lhhvvp/norma-core-dev/software/station/clients/station-viewer/README.md

# Station Viewer

Web interface for NormaCore.Dev station - physical operations platform.

## Features

- Real-time robot state visualization
- ST3215 servo bus monitoring and calibration
- USB video frame viewing
- System info monitoring
- Timeline-based history navigation
- 3D robot visualization (URDF support)

## Development

```bash
# Install dependencies
yarn install

# Start development server
yarn dev

# Build for production
yarn build

# Type checking
yarn type-check

# Lint
yarn lint
```

## Tech Stack

- React 19
- TypeScript
- Vite
- TailwindCSS
- Three.js
- Protocol Buffers

## License

MIT
