lhhvvp/norma-core-dev/docs/superpowers/plans/2026-04-10-simulation-integration-mvp1.md

# NormaCore Simulation Integration — MVP-1 Implementation Plan

> **For agentic workers:** REQUIRED: Use `superpowers:subagent-driven-development` (if subagents available) or `superpowers:executing-plans` to implement this plan. Steps use checkbox (`- [ ]`) syntax for tracking.

**Goal:** Implement the MVP-1 scope of the v2 simulation integration design so that `station -c station-sim.yaml` boots Station with a MuJoCo-backed simulated ElRobot follower, web UI shows the robot responding to joint commands, the gripper mimic works through MJCF `<equality>` constraints, and shadow mode (real + sim coexistence) is configurable but not required.
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
