lhhvvp/norma-core-dev/hardware/elrobot/simulation/mujoco/elrobot_follower/elrobot_follower.png

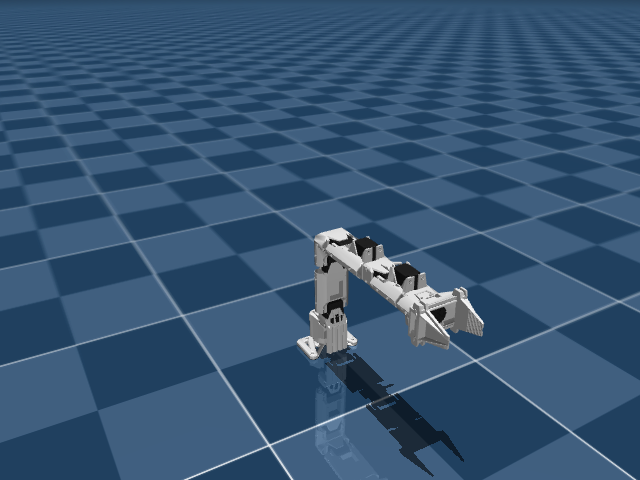
hardware/elrobot/simulation/mujoco/elrobot_follower/elrobot_follower.png
