lhhvvp/norma-core-dev/hardware/elrobot/print/basic/elrobot_full_basic.3mf

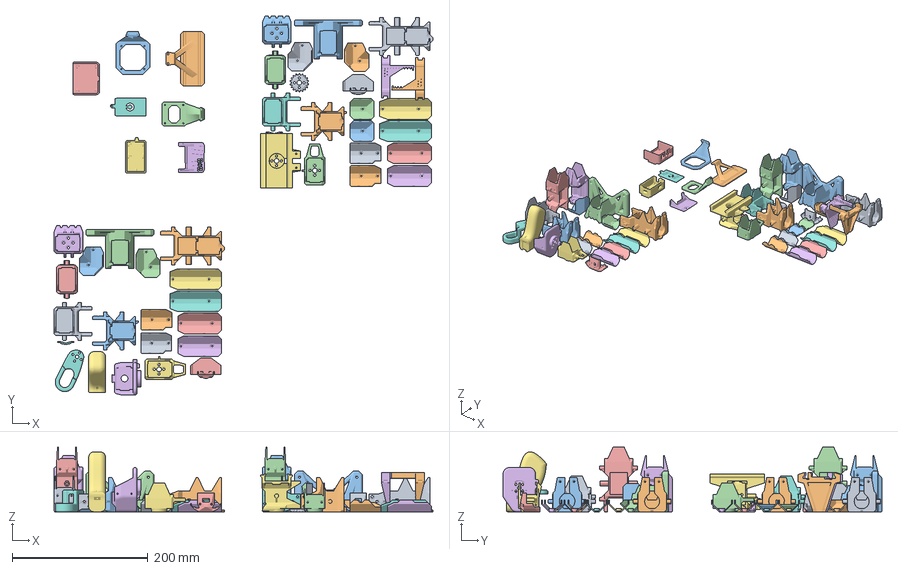
[picture p4: CAD file, 2026-04-08]
hardware/elrobot/print/basic/elrobot_full_basic.3mf
557.0 x 557.5 x 95.0 mm
Base Shield.stl x 2
CameraMount_regular.stl
CameraMount_square_34mm.stl
CameraMount_square_27mm.stl
ws_enclosure_case.stl
ws_enclosure_lid.stl
ss_enclosure_case.stl
ss_enclosure_lid.stl
Gripper Gear.stl
Gripper Jaw.stl x 2
Joint 1.stl x 2
Joint 5.stl x 2
Wiring_bracket.stl x 2
Gripper Base.stl
Joint 3.stl x 2
Joint 4.stl x 2
Joint 6.stl x 2
Base.stl x 2
Joint_02.stl x 2
Wrist_Roll_SO101.stl
Handle_SO101.stl
Trigger_SO101.stl
Joint 3 Shield Drive Side.stl x 2
Joint 3 Shield Camera Side.stl x 2
Gripper Base Shield.stl x 2
Joint 2 Shield.stl x 4
Joint 4 Shield.stl x 4
Joint 6 Shield.stl x 4
