lhhvvp/norma-core-dev/hardware/elrobot/print/ams/elrobot_leader_ams.3mf

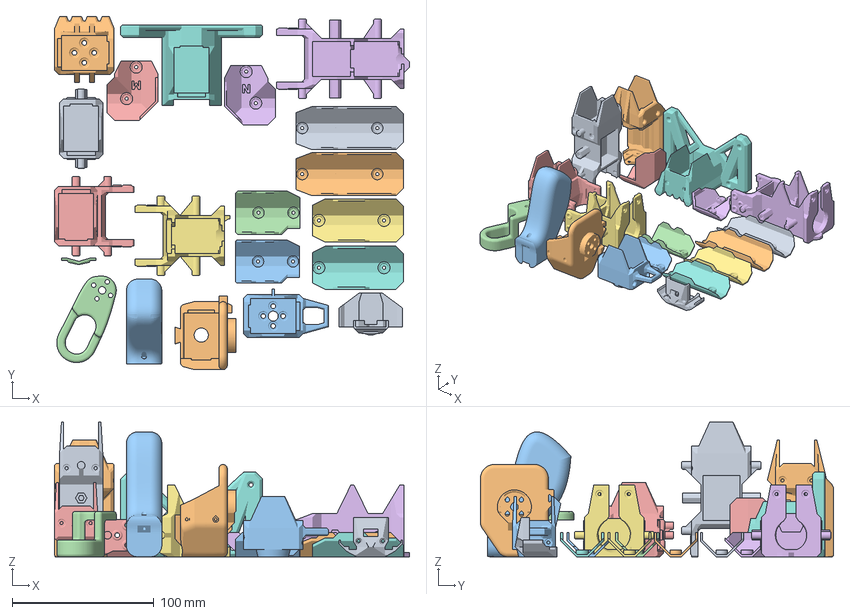
[picture p6: CAD file, 2026-04-08]
hardware/elrobot/print/ams/elrobot_leader_ams.3mf
250.5 x 249.2 x 95.0 mm
Base Shield.stl
Joint 1.stl
Joint 5.stl
Wiring_bracket.stl
Joint 3.stl
Joint 4.stl
Joint 6.stl
Base.stl
Joint_02.stl
Wrist_Roll_SO101.stl
Handle_SO101.stl
Trigger_SO101.stl
Joint 3 Shield Drive Side.stl
Joint 3 Shield Camera Side.stl
Joint 2 Shield.stl x 2
Joint 4 Shield.stl x 2
Joint 6 Shield.stl x 2
