lhhvvp/norma-core-dev/hardware/elrobot/simulation/mujoco/elrobot_follower/assets/Joint_01_1.stl

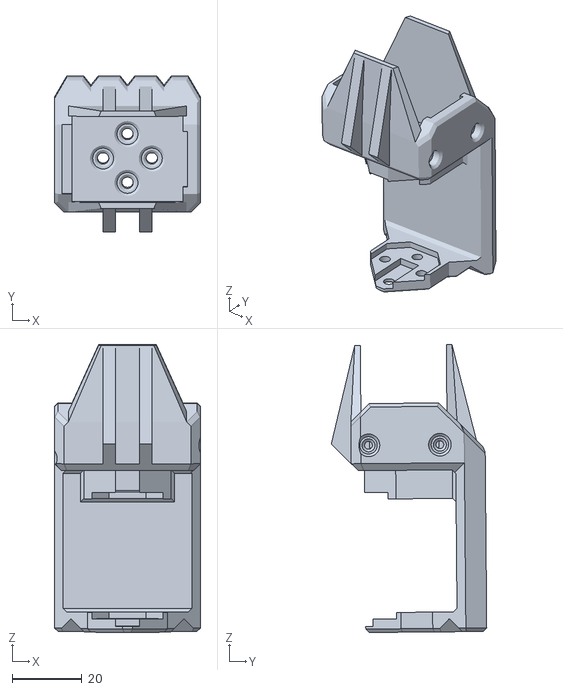
[picture p7: CAD file, 2026-03-16]
hardware/elrobot/simulation/mujoco/elrobot_follower/assets/Joint_01_1.stl
42.0 x 44.7 x 82.7
