lhhvvp/norma-core-dev/hardware/elrobot/STEP/elrobot_common_parts/Joint 6.stp

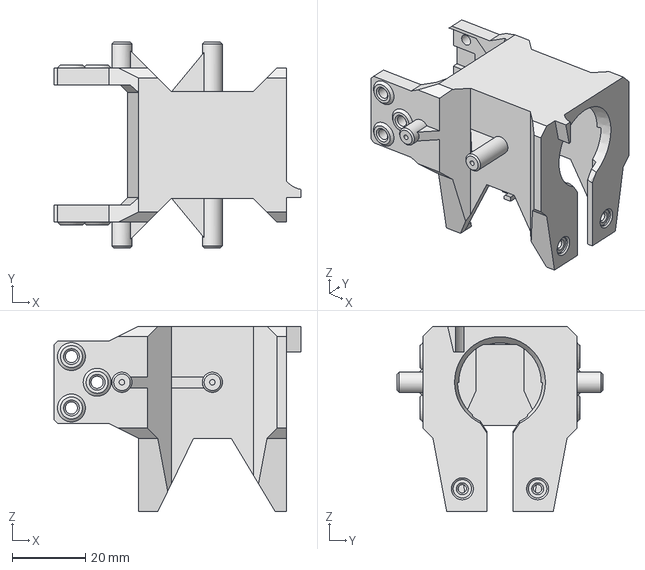
[picture p8: CAD file, 2026-04-03]
hardware/elrobot/STEP/elrobot_common_parts/Joint 6.stp
67.2 x 56.0 x 50.5 mm
