lhhvvp/norma-core-dev/hardware/elrobot/STEP/elrobot_follower_parts/individual/Gripper_Base_Shield.stp

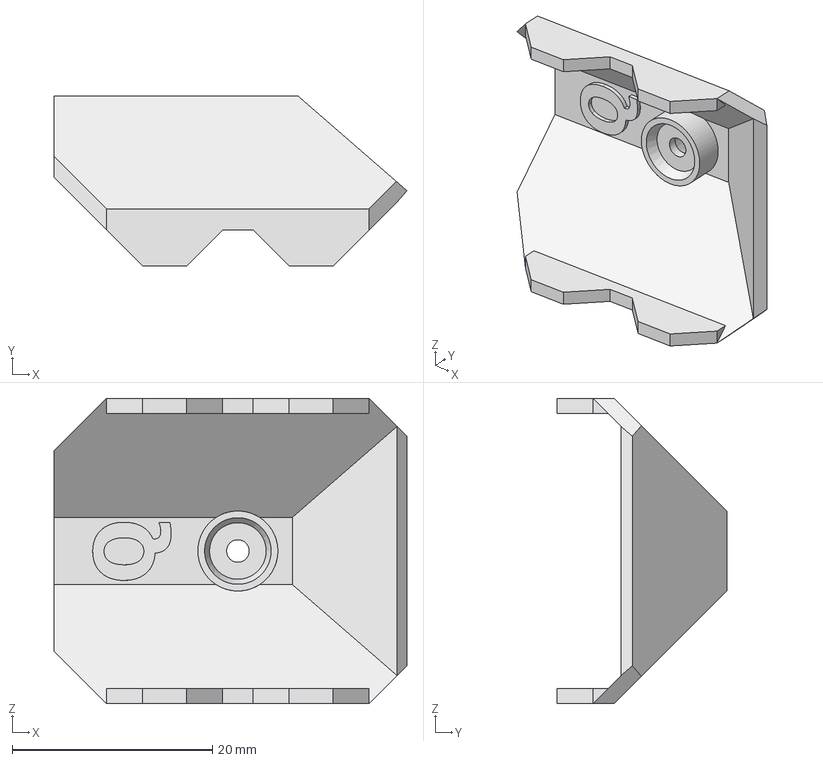
[picture p9: CAD file, 2026-04-08]
hardware/elrobot/STEP/elrobot_follower_parts/individual/Gripper_Base_Shield.stp
35.3 x 17.0 x 30.5 mm
