lhhvvp/norma-core-dev/hardware/pgripper/STEP/Gripper.stp

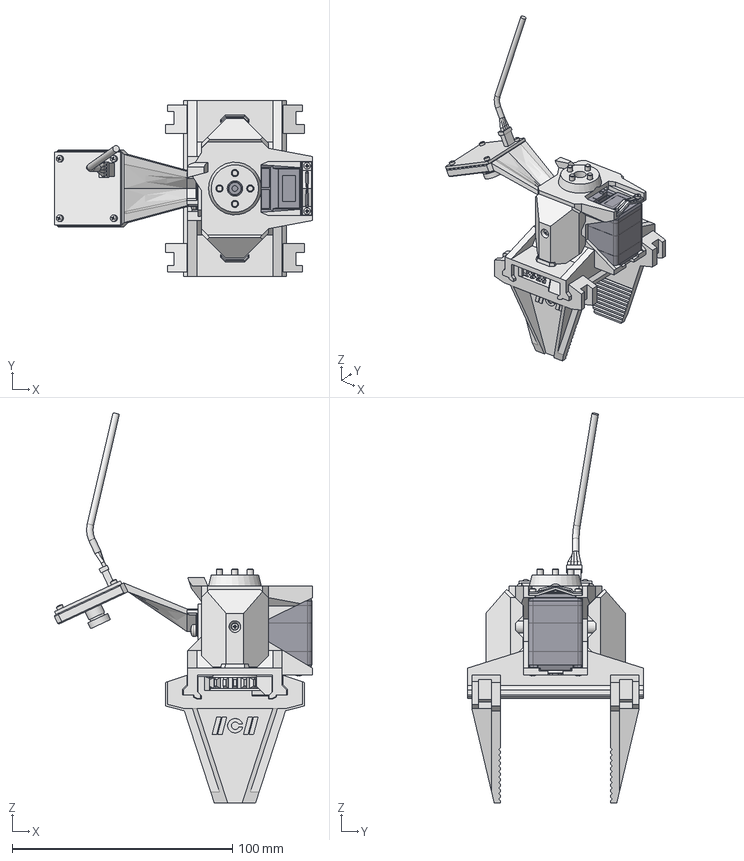
[picture p10: CAD file, 2026-04-08]
hardware/pgripper/STEP/Gripper.stp
117.2 x 80.0 x 177.0 mm
Gripper_Base
Gripper Gear
Gripper_Jaw x 2
Gripper_Base_Shield x 2
CameraMount_square32mm
Wiring_bracket
UVC_Camera
Idler Horn
CRFHTSTATI ANSI B18.6.4 - 1-42 x 3/16 Steel Grade 2 Plain x 10
DIN EN ISO 7045 - M3 x 6 - H Steel 4.6 Plain x 11
Servo ST3215_1
Servo Horn
