lhhvvp/norma-core-dev/hardware/pgripper/STL/print/gripper_34mm_camera_mount.stl

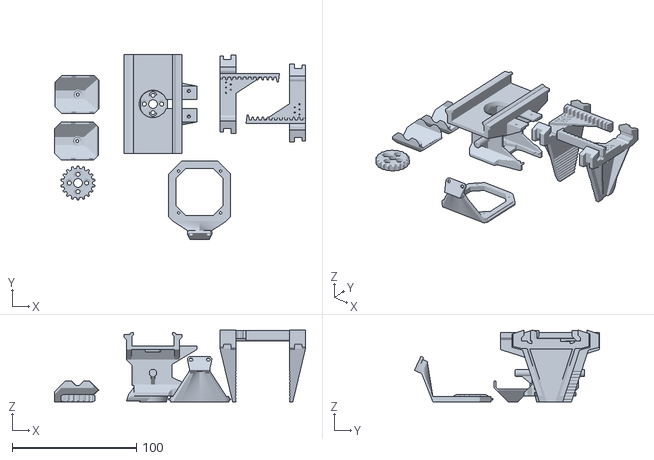
[picture p11: CAD file, 2026-04-08]
hardware/pgripper/STL/print/gripper_34mm_camera_mount.stl
202.2 x 149.2 x 58.0
