lhhvvp/norma-core-dev/software/station/clients/station-viewer/public/so101/assets/leader_wrist_roll_so101_scale_1_1000.stl

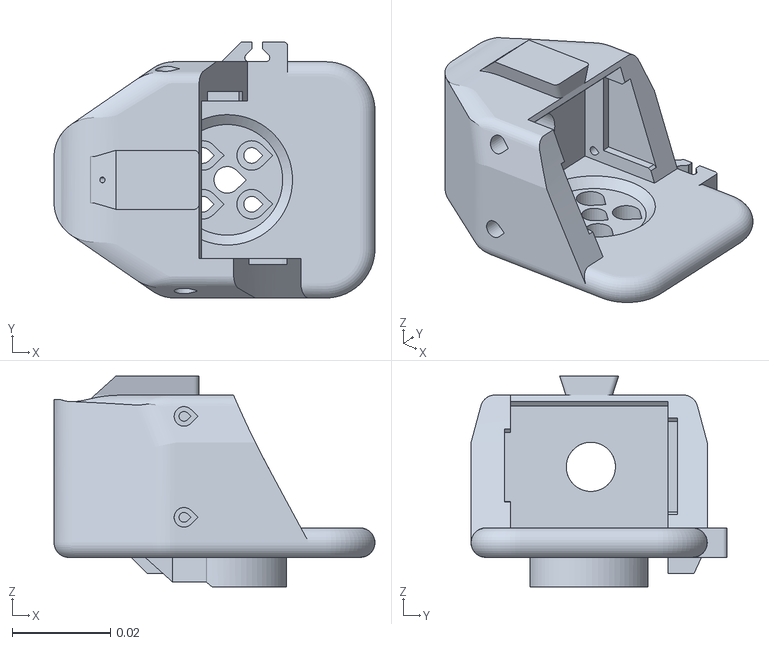
[picture p12: CAD file, 2026-03-16]
software/station/clients/station-viewer/public/so101/assets/leader_wrist_roll_so101_scale_1_1000.stl
0.0652 x 0.052 x 0.0429
