lhhvvp/norma-core-dev/hardware/elrobot/simulation/mujoco/elrobot_follower/assets/Joint_04_v1_1.stl

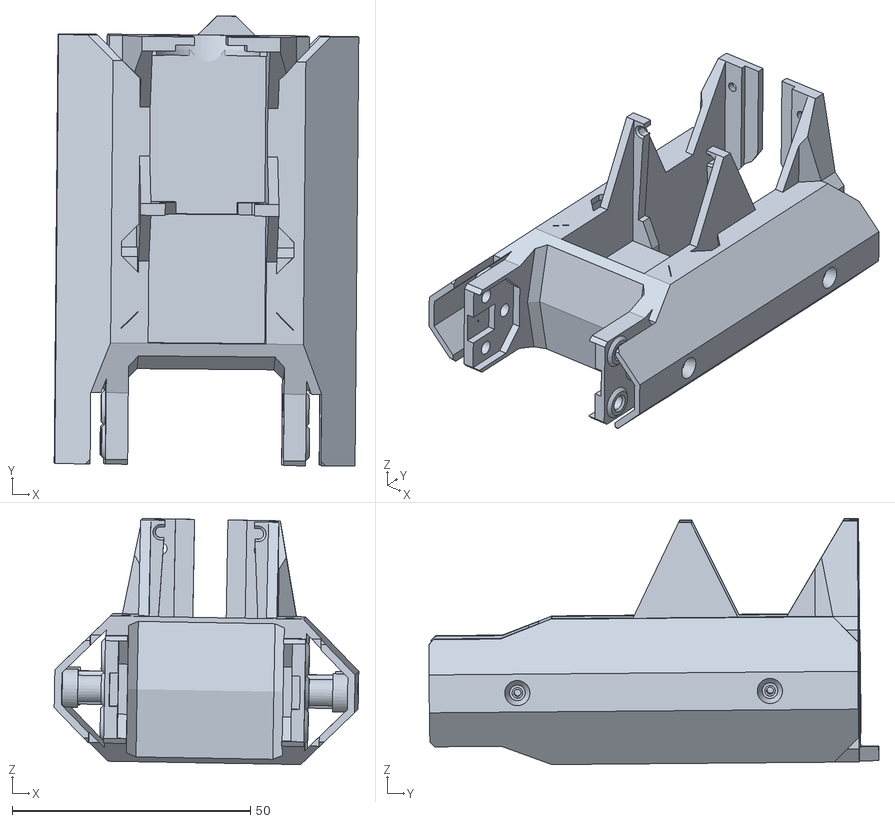
[picture p14: CAD file, 2026-03-16]
hardware/elrobot/simulation/mujoco/elrobot_follower/assets/Joint_04_v1_1.stl
63.9 x 94.4 x 51.7
