lhhvvp/norma-core-dev/hardware/elrobot/STEP/elrobot_follower_parts/individual/Gripper_Base.stp

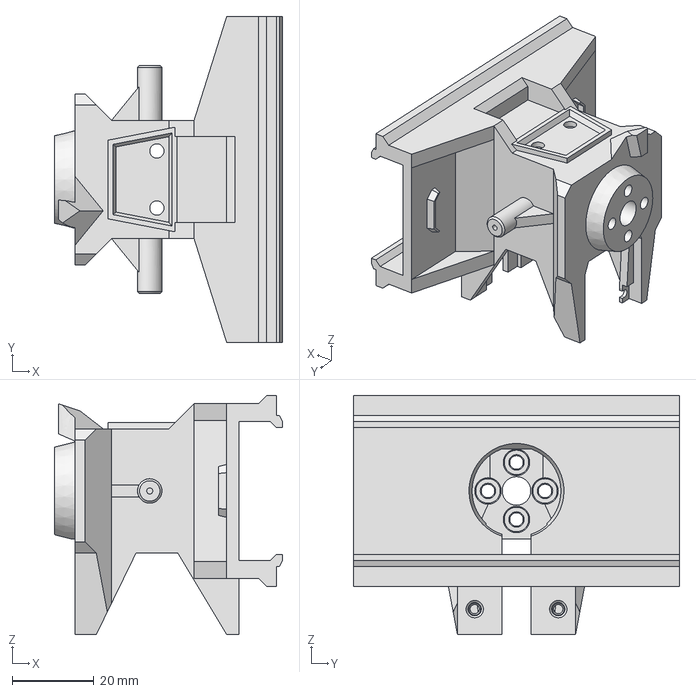
[picture p15: CAD file, 2026-04-03]
hardware/elrobot/STEP/elrobot_follower_parts/individual/Gripper_Base.stp
56.0 x 80.0 x 58.7 mm
