lhhvvp/norma-core-dev/hardware/pgripper/STL/print/basic.3mf

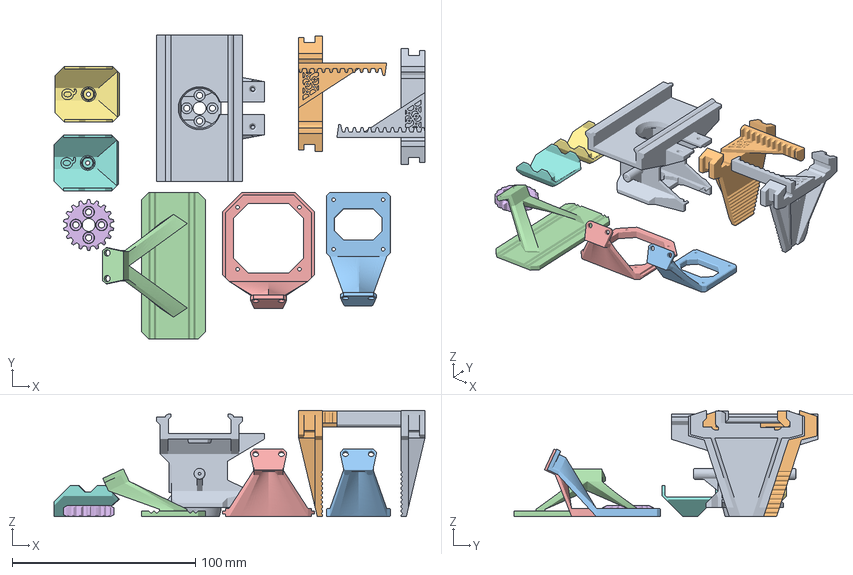
[picture p16: CAD file, 2026-04-08]
hardware/pgripper/STL/print/basic.3mf
202.2 x 165.9 x 58.0 mm
Gripper_Jaw_v04.stl x 2
CameraMount_square32mm_v03.stl
CameraMount_v02.stl
CameraMount_square33,75mm_v01.stl
Gripper_Gear_v01.stl
Gripper_Base_Shield.stl x 2
Gripper_Base.stl
