lhhvvp/norma-core-dev/software/station/clients/station-viewer/public/so101/assets/leader_trigger_so101_scale_1_1000.stl

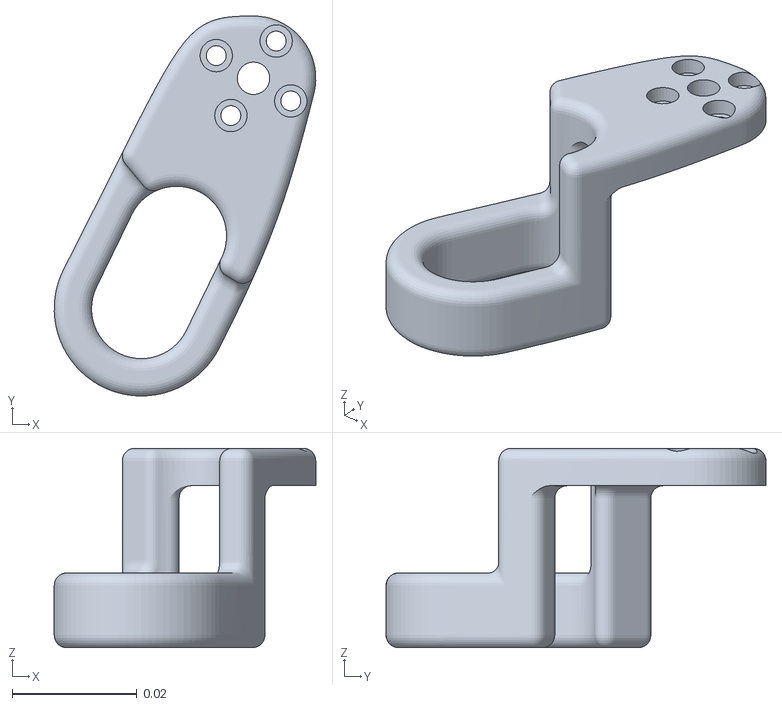
[picture p17: CAD file, 2026-03-16]
software/station/clients/station-viewer/public/so101/assets/leader_trigger_so101_scale_1_1000.stl
0.042 x 0.061 x 0.032
