lhhvvp/norma-core-dev/hardware/elrobot/simulation/mujoco/elrobot_follower/assets/Gripper_Gear_v1_1.stl

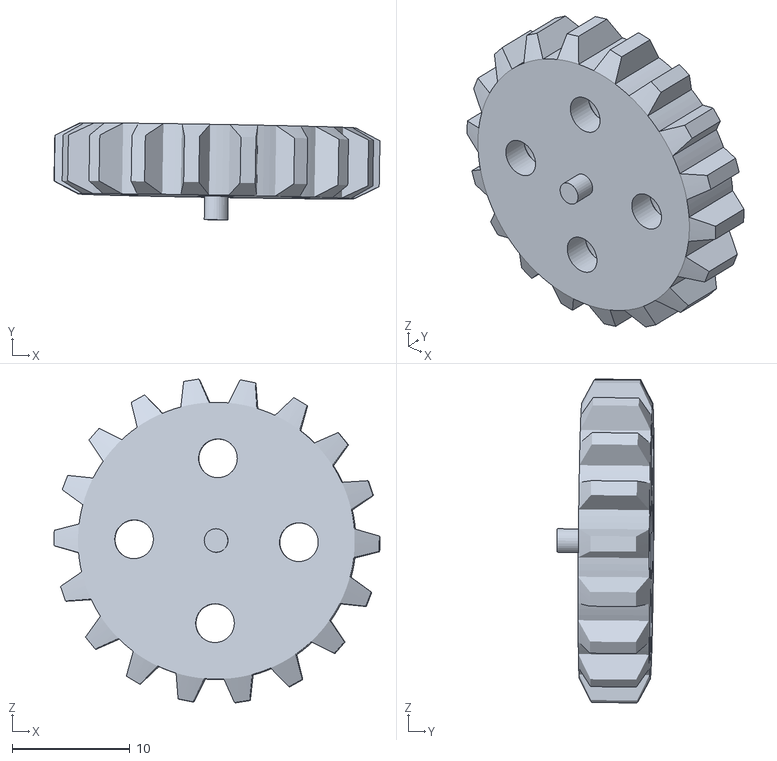
[picture p18: CAD file, 2026-03-16]
hardware/elrobot/simulation/mujoco/elrobot_follower/assets/Gripper_Gear_v1_1.stl
27.7 x 8.25 x 27.5
