lhhvvp/norma-core-dev/hardware/pgripper/STL/print/gripper_no_camera_mount.stl

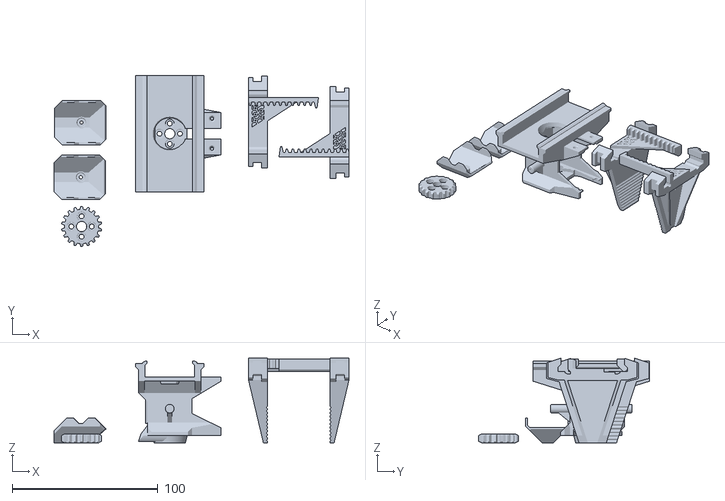
[picture p19: CAD file, 2026-04-08]
hardware/pgripper/STL/print/gripper_no_camera_mount.stl
202.2 x 117.4 x 58.0
