lhhvvp/norma-core-dev/software/station/clients/station-viewer/public/so101/assets/leader_handle_so101_scale_1_1000.stl

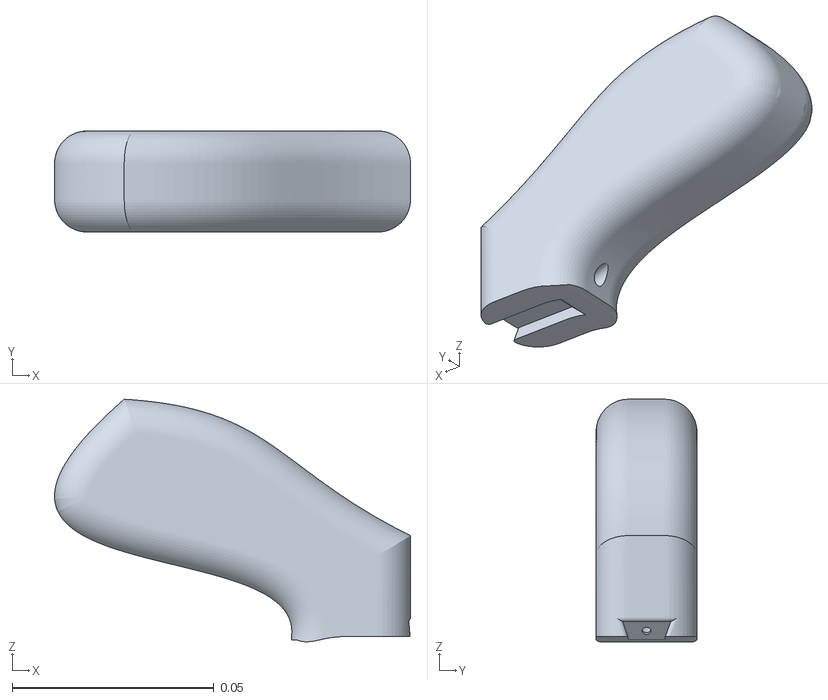
[picture p20: CAD file, 2026-03-16]
software/station/clients/station-viewer/public/so101/assets/leader_handle_so101_scale_1_1000.stl
0.0881 x 0.025 x 0.0601
