lhhvvp/norma-core-dev/hardware/elrobot/simulation/mujoco/elrobot_follower/assets/Gripper_Jaw_02_v1_1.stl

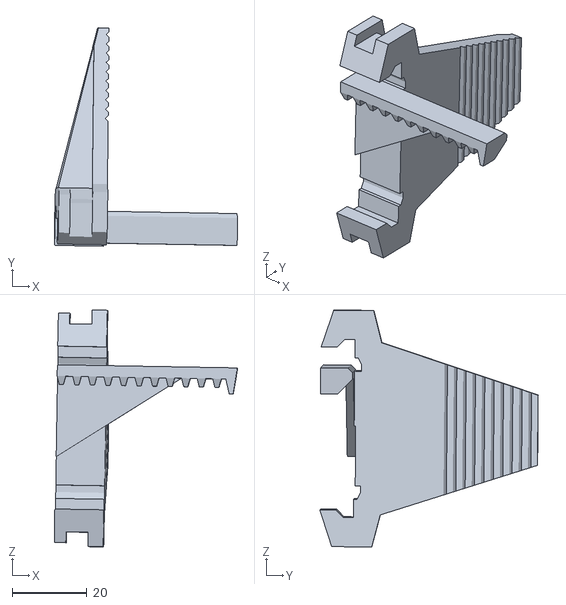
[picture p21: CAD file, 2026-03-16]
hardware/elrobot/simulation/mujoco/elrobot_follower/assets/Gripper_Jaw_02_v1_1.stl
48.9 x 58.3 x 63.2
