lhhvvp/norma-core-dev/hardware/elrobot/simulation/mujoco/elrobot_follower/assets/ST3215_7_v1_1.stl

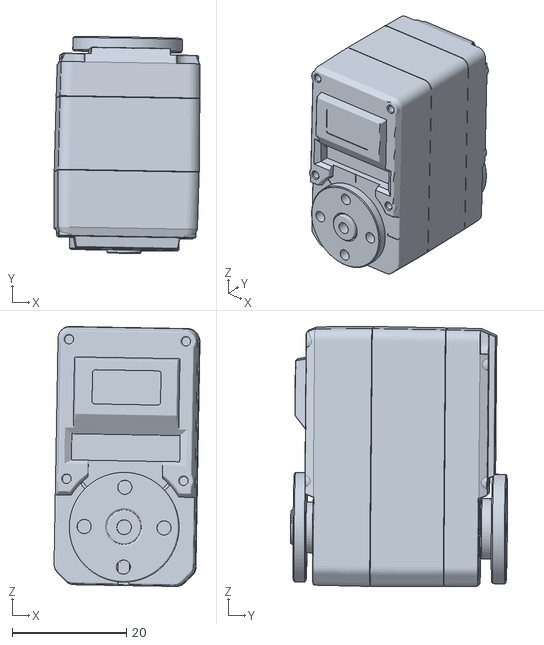
[picture p22: CAD file, 2026-03-16]
hardware/elrobot/simulation/mujoco/elrobot_follower/assets/ST3215_7_v1_1.stl
25.6 x 38.0 x 45.6
