lhhvvp/norma-core-dev/hardware/pgripper/STL/print/gripper_27mm_camera_mount.stl

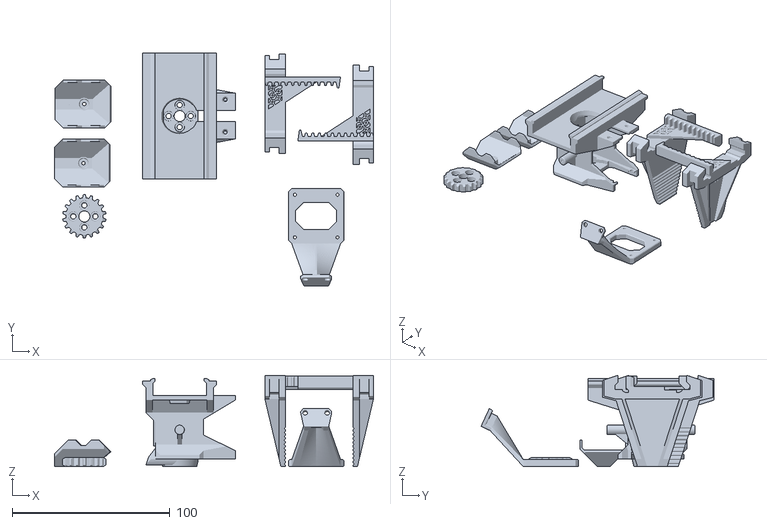
[picture p23: CAD file, 2026-04-08]
hardware/pgripper/STL/print/gripper_27mm_camera_mount.stl
202.2 x 147.7 x 58.0
