lhhvvp/norma-core-dev/hardware/elrobot/simulation/mujoco/elrobot_follower/assets/ST3215_1_v1_1.stl

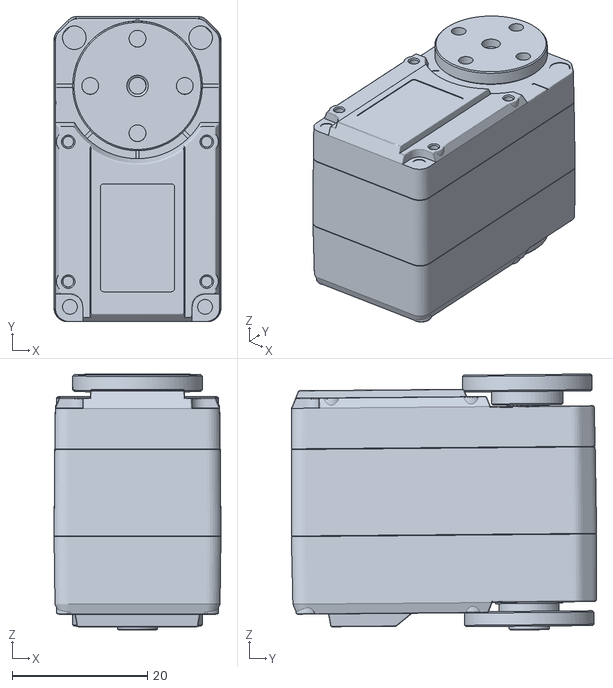
[picture p24: CAD file, 2026-03-16]
hardware/elrobot/simulation/mujoco/elrobot_follower/assets/ST3215_1_v1_1.stl
24.7 x 45.2 x 37.9
