lhhvvp/norma-core-dev/hardware/pgripper/STL/print/gripper_generic_camera_mount.stl

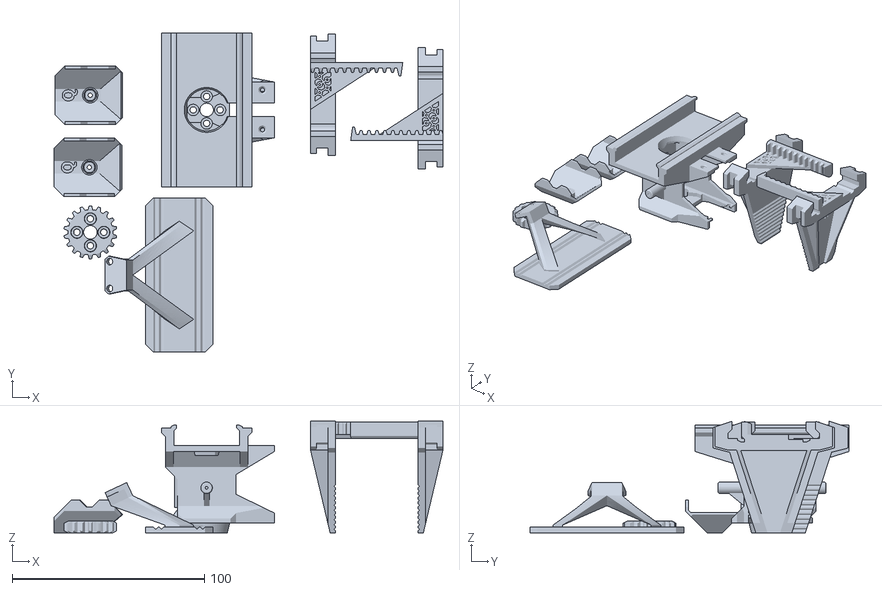
[picture p25: CAD file, 2026-04-08]
hardware/pgripper/STL/print/gripper_generic_camera_mount.stl
202.2 x 165.9 x 58.0
