lhhvvp/norma-core-dev/hardware/elrobot/simulation/mujoco/elrobot_follower/assets/Joint_03_v1_1.stl

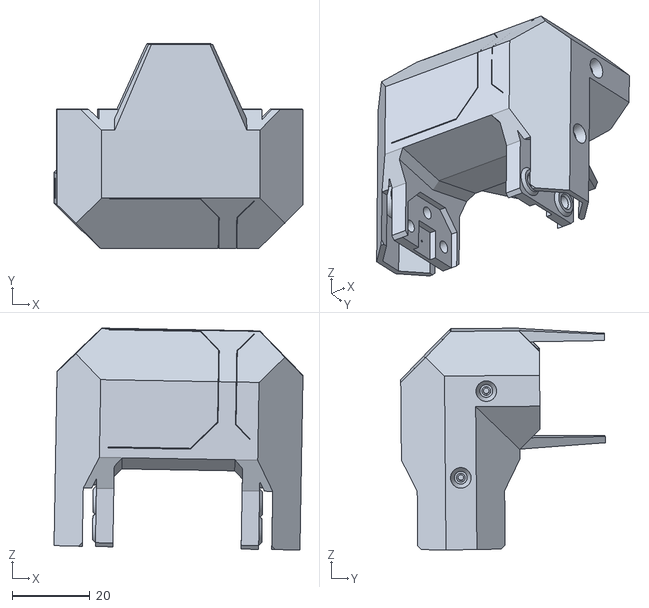
[picture p26: CAD file, 2026-03-16]
hardware/elrobot/simulation/mujoco/elrobot_follower/assets/Joint_03_v1_1.stl
64.1 x 52.6 x 57.1
