lhhvvp/norma-core-dev/hardware/elrobot/simulation/mujoco/elrobot_follower/assets/base_link.stl

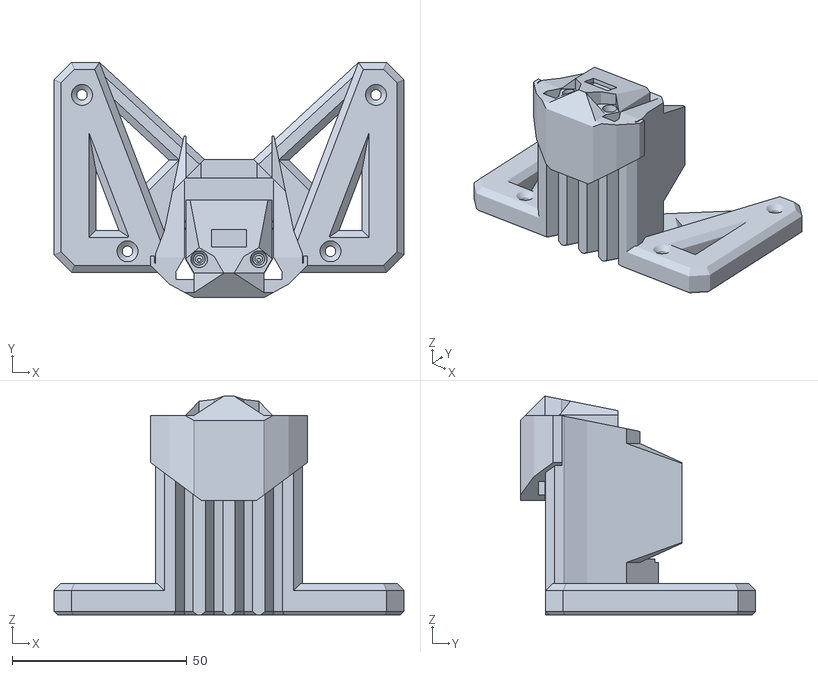
[picture p27: CAD file, 2026-03-16]
hardware/elrobot/simulation/mujoco/elrobot_follower/assets/base_link.stl
100.0 x 67.3 x 62.5
