lhhvvp/norma-core-dev/hardware/elrobot/simulation/mujoco/elrobot_follower/assets/Gripper_Base_v1_1.stl

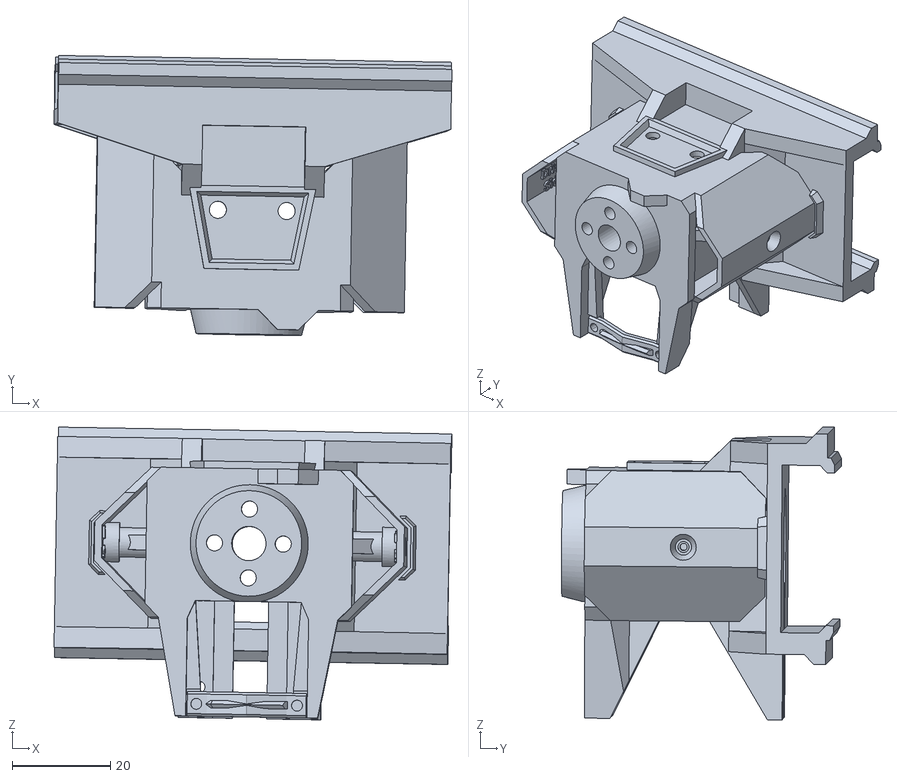
[picture p28: CAD file, 2026-03-16]
hardware/elrobot/simulation/mujoco/elrobot_follower/assets/Gripper_Base_v1_1.stl
81.0 x 57.0 x 59.6
