lhhvvp/norma-core-dev/hardware/elrobot/simulation/mujoco/elrobot_follower/assets/Joint_05_v1_1.stl

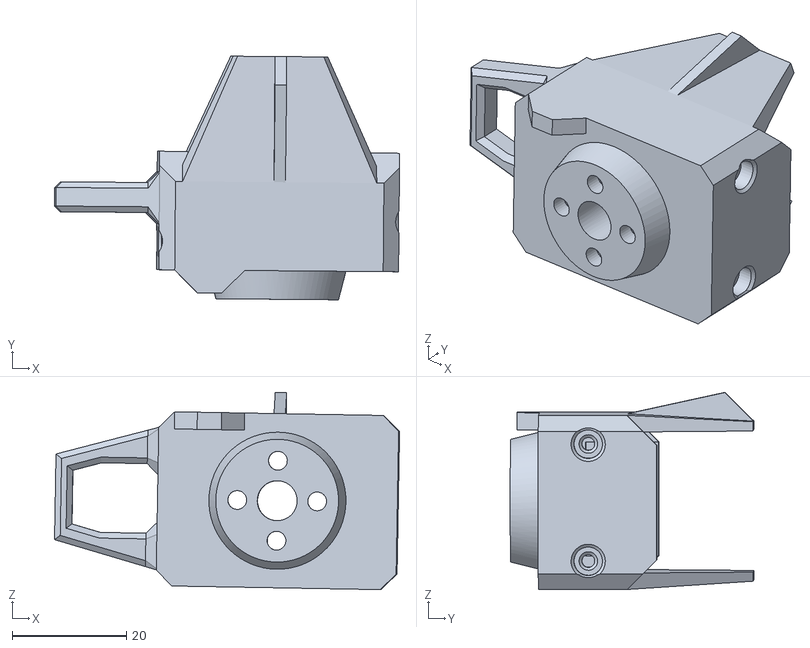
[picture p29: CAD file, 2026-03-16]
hardware/elrobot/simulation/mujoco/elrobot_follower/assets/Joint_05_v1_1.stl
60.4 x 42.7 x 34.5
