lhhvvp/norma-core-dev/hardware/elrobot/simulation/mujoco/elrobot_follower/assets/Joint_06_v1_1.stl

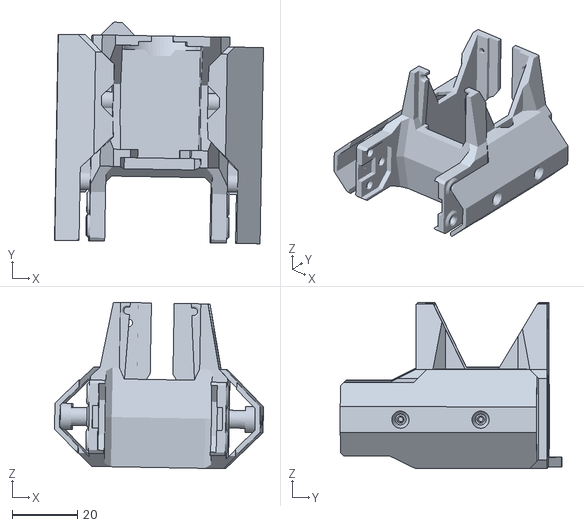
[picture p30: CAD file, 2026-03-16]
hardware/elrobot/simulation/mujoco/elrobot_follower/assets/Joint_06_v1_1.stl
64.2 x 68.0 x 51.1
