lhhvvp/norma-core-dev/hardware/elrobot/simulation/mujoco/elrobot_follower/assets/ST3215_3_v1_1.stl

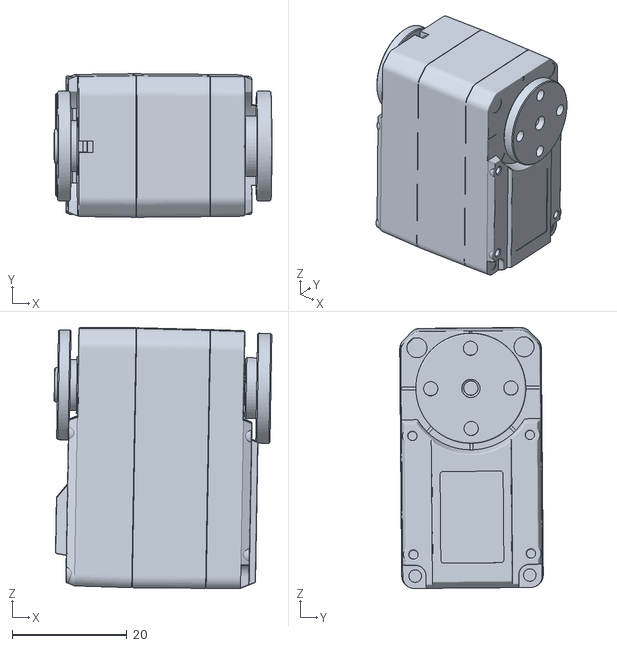
[picture p31: CAD file, 2026-03-16]
hardware/elrobot/simulation/mujoco/elrobot_follower/assets/ST3215_3_v1_1.stl
38.0 x 25.1 x 45.5
