lhhvvp/norma-core-dev/(list of files, cad)

Other CAD files:
hardware/elrobot/print/ams/elrobot_full_ams.3mf
hardware/elrobot/print/basic/elrobot_leader_basic.3mf
hardware/elrobot/STL/elrobot_individual_parts/elrobot_common_parts/Joint 6.stl
hardware/elrobot/STL/elrobot_individual_parts/elrobot_follower_parts/Gripper Base Shield.stl
hardware/elrobot/STL/elrobot_individual_parts/elrobot_follower_parts/Gripper Base.stl
hardware/elrobot/print/basic/elrobot_follower_basic.3mf
hardware/pgripper/STL/print/ams.3mf
hardware/elrobot/simulation/mujoco/elrobot_follower/assets/ST3215_4_v1_1.stl
hardware/elrobot/simulation/mujoco/elrobot_follower/assets/ST3215_6_v1_1.stl
hardware/elrobot/simulation/mujoco/elrobot_follower/assets/ST3215_2_v1_1.stl
hardware/elrobot/simulation/mujoco/elrobot_follower/assets/Gripper_Jaw_01_v1_1.stl
hardware/elrobot/simulation/mujoco/elrobot_follower/assets/ST3215_5_v1_1.stl
hardware/elrobot/simulation/mujoco/elrobot_follower/assets/ST3215_8_v1_1.stl
hardware/pgripper/STL/individual/Gripper Base Shield.stl
hardware/pgripper/STL/individual/Gripper_Base.stl
