lhhvvp/norma-core-dev/software/station/shared/station-iface/src/lib.rs

mod traits;
pub mod config;

pub const COMMANDS_QUEUE_ID: &str = "commands";

pub use config::{
    Bridges, LogCapture, SimMode, SimRuntimeConfig, St3215CompatBridgeConfig,
};
pub use traits::*;

pub mod iface_proto {
    pub mod drivers {
        include!("proto/drivers.rs");
    }
    pub mod opts {
        include!("proto/opts.rs");
    }
    pub mod envelope {
        include!("proto/station.rs");
    }
    pub mod commands {
        include!("proto/commands.rs");
    }
    pub mod inference {
        include!("proto/inference.rs");
    }
}
