lhhvvp/norma-core-dev/(commit log)

2026-02-26 fix prime tower collision for ams print files
    [elrobot_full_ams.3mf, elrobot_full_ams_dual.3mf]
2026-03-16 station pre-release data
    [Gripper_Base_v1_1.stl, Gripper_Gear_v1_1.stl, Gripper_Jaw_01_v1_1.stl, Gripper_Jaw_02_v1_1.stl, Joint_01_1.stl, Joint_02_1.stl, Joint_03_v1_1.stl, Joint_04_v1_1.stl]
2026-03-16 disable wide-angle camera, fix history page
2026-03-18 id change flow interface update: info about possible errors, track motor commands log
2026-03-18 motor id change error prevention
2026-03-20 calibration: allow to provide arcs by api
2026-04-03 Improve mechanical stopper compatibility with so101 for the gripper
    [Gripper Base.stl, Gripper_Base.stl, Gripper_Base.stp, Joint 6.stl, Joint 6.stp, ams.3mf, basic.3mf, elrobot_follower_ams.3mf]
2026-04-07 add temperatures to motors view
2026-04-07 elrobot auto-calibration updates
2026-04-10 spec: simulation integration v2 (after codex architectural review)
    v1 was written and passed the initial spec-document-reviewer loop but a
    subsequent codex deep architectural review (session id
    019d7726-6dcf-7fe2-8887-35ee3b9c2568) identified six structural issues
    serious enough to warrant a full rewrite. v1 is archived in this commit
    alongside the new v2 for reference.
    The central critique from codex: "v1 models the shared simulation world
    as a fake ST3215 driver — MVP-1 can run but MVP-2 onward bleeds from that
    seam." v1 was two designs pasted together (shared world service + fake
    device), with no unifying core abstraction.
    v2 replaces the fake-driver-shim design with a properly layere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
2026-04-10 spec v2 revision 1: fix blockers + major findings from double review
    After writing v2 spec, ran two parallel reviews:
    - spec-document-reviewer subagent (factual / referential correctness)
    - codex second-opinion via resumed session (architectural depth)
    Codex found two hard blockers that the subagent missed (because they
    are structural, not surface-level):
    BLOCKER 1 — Bridge command ingress was fictitious
    v2 spec said st3215-compat-bridge subscribes to "st3215/commands"
    queue. That queue does not exist. The real legacy entry point is
    the global "commands" queue (station_iface::COMMANDS_QUEUE_ID =
    "commands"), which the real st3215 driver subscribes to and filters
    by StationComma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
2026-04-10 plan: add MVP-1 implementation plan header + Chunk 1 (with reviewer fixes)
    Initial plan file for the simulation integration MVP-1 implementation.
    Covers the foundation chunk (proto + manifest + MJCF + gen.py) in
    detail; chunks 2-8 are outlined and will be fleshed out one at a time
    as each chunk passes its reviewer cycle.
    Chunk 1 has been through one plan-document-reviewer pass. Reviewer
    found 2 critical issues (MJCF <include> can't embed URDF, relative_to
    raises ValueError) plus 3 major (write_manifest source-control hazard,
    80-line monolithic step, mujoco install timing) plus 7 minor. All
    fixed in this commit.
    Key design changes from the first draft after reviewer feedback:
    - build_mjcf n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
2026-04-10 plan: add Chunks 2-8 (batched) — complete MVP-1 implementation plan
    Adds detailed task-by-task plans for:
    Chunk 2: st3215-wire crate (7 tasks, ~546 lines)
    Chunk 3: sim-runtime foundation (10 tasks, ~650 lines)
    Chunk 4: sim-runtime subsystem (9 tasks, ~507 lines)
    Chunk 5: norma_sim Python world + scheduler (11 tasks, ~534 lines)
    Chunk 6: norma_sim Python ipc + CLI + diagnostics (10 tasks, ~462 lines)
    Chunk 7: st3215-compat-bridge (8 tasks, ~673 lines)
    Chunk 8: Station integration + E2E + smoke test (12 tasks, ~485 lines)
    Each chunk has: file structure, TDD-style sub-steps with exact commands,
    verification assertions, commit instructions, and an exit checklist.
    Code snippets a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
2026-04-10 hardware: add elrobot_follower.world.yaml manifest + README
    The manifest is the single human-editable source of truth for the
    ElRobot follower simulation world. It declares actuator capabilities
    (REVOLUTE_POSITION vs GRIPPER_PARALLEL), mimic joint structure, and
    scene parameters. Revolute actuator limits are NOT in the manifest;
    they come from the URDF via gen.py → MJCF ctrlrange. GRIPPER_PARALLEL
    is the exception because its normalized 0..1 range is not in URDF.
    See docs/superpowers/specs/2026-04-10-simulation-integration-design.md
    section 9.2 for manifest schema rationale.
    [elrobot_follower.world.yaml]
2026-04-10 worlds: add gen.py skeleton with CLI, manifest loading, source_hash
    gen.py loads world.yaml and validates that the referenced URDF exists,
    computes sha256(urdf + manifest) for later embedding, and stubs the
    MJCF-building and self-check bodies. The build uses MuJoCo's own URDF
    loader (Task 1.4), not an <include> shim. No manifest writeback —
    revolute limits flow URDF → MJCF directly.
2026-04-10 worlds: implement gen.py MJCF builder (two-phase MuJoCo pipeline)
    Phase 0 (deviation from plan §1.4): preprocess URDF by injecting a
    <mujoco><compiler meshdir=<abs>/assets inertiafromgeom=true
    balanceinertia=true/></mujoco> element into a temp URDF copy.
    Needed because:
    - MuJoCo's URDF loader strips path prefixes from mesh filenames
    and resolves via meshdir (not relative to the URDF)
    - The ElRobot URDF has zero-inertia bodies on the gripper mimic
    chain which MuJoCo rejects; inertiafromgeom recomputes from
    mesh geometry (also standard practice in urdfpy-style converters)
    Phase 1: mujoco.MjModel.from_xml_path + mj_s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
2026-04-10 worlds: add gen.py self-check for manifest/MJCF consistency
    Seven checks enforced after MJCF generation:
    1. compiler.angle == 'radian'
    2. option.timestep matches manifest scene.timestep
    3. every manifest mjcf_actuator name exists in MJCF <actuator>
    4. every manifest urdf_joint is referenced by an MJCF <position>
    5. every gripper mimic joint is in MJCF <equality>
    6. each <equality> polycoef c1 exactly matches manifest multiplier
    7. URDF/MJCF actuator limits coverage via (3)+(4)
    Self-check failures exit with code 2 and a clear error message.
    Verified via direct unit test with a hand-constructed bad MJCF
    (missing equality section) — raises the expected ValueError.
    Co-Authored-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
2026-04-10 worlds: switch gripper mimic to tendon-based equality
    Deviation from plan §1.4 Step 1c (joint-joint polycoef equality) —
    that approach did not enforce the constraint reliably because
    MuJoCo's joint equality Jacobian spans disparate units for
    hinge-prismatic coupling (rad vs m), and the solver treats such
    mixed-unit constraints as very soft, leaving slide joints at ~1mm
    instead of the expected ~11mm at target = 1 rad.
    The canonical MuJoCo way to express URDF <mimic> is via a fixed
    <tendon> whose length is a weighted sum of joint coordinates,
    constrained to 0 by a tendon <equality>. This collapses the
    coupling to a single scalar constraint the solver can enforce
    with high stiffness.
    For e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
2026-04-11 st3215-wire: add crate skeleton with placeholder modules
    Empty module stubs so lib.rs re-exports resolve and cargo build
    succeeds. Task 2.1 of Chunk 2. Real content migrated in Tasks 2.2-2.6.
    Zero I/O deps (no tokio, normfs, station_iface) — enforced by
    check-arch-invariants in Chunk 8.
    [layout.rs, lib.rs, pack.rs, presets.rs, register.rs, units.rs, unpack.rs]
2026-04-11 st3215-wire: migrate register enums + byte-layout constants from st3215
    register.rs: verbatim copy of define_register_enum! macro + both
    EepromRegister and RamRegister invocations from
    software/drivers/st3215/src/protocol/memory.rs. Diff of
    {old,new}_registers.txt is empty — all 30 EEPROM + 15 RAM variants
    preserved with unchanged addresses and sizes.
    layout.rs: derived byte-boundary constants EEPROM_BYTES=40,
    RAM_BYTES=31, TOTAL_BYTES=71 plus a zero DEFAULT_EEPROM baseline
    that pack_state_bytes (Task 2.5) will overlay spec/instance values
    onto.
    Task 2.2 of Chunk 2.
2026-04-11 st3215-wire: migrate unit conversions + add inverse helpers
    Two groups of helpers now live in st3215-wire/src/units.rs:
    1. Byte-slice extractors migrated verbatim from
    st3215/src/protocol/units.rs:
    - normal_position, get_motor_{position,goal_position,current,velocity}
    - normalize_motor_position
    - is_motor_error, is_torque_enabled
    The only edit is the import path
    `use super::memory::RamRegister`
    → `use crate::register::RamRegister`.
    2. New pure semantic conversions required by pack.rs / unpack.rs:
    - STEPS_PER_REV (= 4096)
    - steps_to_rad / rad_to_steps (with configurable offset)
    - sign_magnitude_to_i16 / i16_to_sign_magnitud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
2026-04-11 st3215-wire: add unpack_state_bytes (pure parsing)
    Decodes a 71-byte ST3215 memory dump into a MotorSemanticState:
    - position_rad, velocity_rad_s, goal_position_rad via steps↔rad
    conversion (offset from MotorInstance)
    - present velocity is sign-magnitude decoded first
    - torque_enabled, moving, temperature_c as scalar fields
    Errors:
    - TooShort { expected, actual } when buffer < TOTAL_BYTES (71)
    - ModelMismatch { expected, actual } when bytes[0x00..0x02] disagrees
    with spec.model_number
    Also adds MotorInstance::default_test() #[cfg(test)] helper in pack.rs
    so unpack and future pack tests can share a fixture.
    2 unit tests: test_unpack_too_short, test_unpack_model_mismatch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
    [pack.rs, unpack.rs]
2026-04-11 st3215-wire: implement pack_state_bytes + P0 roundtrip test
    pack_state_bytes(motor_id, spec, instance, state) -> Bytes serialises
    a MotorSemanticState into the exact 71-byte layout that the ST3215
    hardware emits on a full-memory read.
    EEPROM overlay (40 bytes):
    0x00-0x01 ModelNumber (spec)
    0x02 FirmwareVersion (spec)
    0x05 ID (motor_id)
    0x06 BaudRate (spec)
    0x09-0x0A MinAngleLimit (instance)
    0x0B-0x0C MaxAngleLimit (instance)
    (other bytes zero via DEFAULT_EEPROM)
    RAM overlay (31 bytes):
    0x28 TorqueEnable (bool)
    0x2A-0x2B GoalPosition (steps from rad_to_steps)
    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
2026-04-11 st3215-wire: add MotorModelSpec + ST3215_STANDARD
    MotorModelSpec carries per-model static parameters that every
    physical instance of a given servo shares: model_number, firmware_
    version, baud_rate_code, steps_per_rev.
    ST3215_STANDARD is the factory-default preset. baud_rate_code=0
    is verified to map to 1_000_000 bps via
    software/drivers/st3215/src/protocol/packet.rs:9 ·
    SUPPORTED_BAUD_RATES[0] = 1_000_000
    software/drivers/st3215/src/driver.rs:258 ·
    port_baud_rate: protocol::SUPPORTED_BAUD_RATES[0]
    The ST3215 register at EEPROM 0x06 stores this index, not raw bps.
    The doc comment above `baud_rate_code` captures the full code table
    for future readers.
    cargo test -p st3215-wire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
2026-04-11 st3215: depend on st3215-wire for protocol types (code move, no logic change)
    Option A (delete + re-export) per plan §2.7:
    1. Cargo.toml: add st3215-wire = { path = "../st3215-wire" }
    2. src/protocol/mod.rs: drop `mod memory;` and `mod units;` (and
    the `#[cfg(test)] mod units_test;` line), then re-export the
    equivalent items from the new crate:
    pub use st3215_wire::{EepromRegister, RamRegister};
    pub use st3215_wire::units::*;
    pub use st3215_wire::layout::{EEPROM_BYTES, RAM_BYTES, TOTAL_BYTES};
    3. Delete: src/protocol/memory.rs, src/protocol/units.rs,
    src/protocol/units_test.rs. Every item they exported is
    now provided verbatim by st3215-wire. No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
2026-04-11 sim-runtime: create crate skeleton + prost world.proto generation
    New workspace member `software/sim-runtime/` with:
    - Cargo.toml (tokio, normfs, prost, tokio-util, thiserror, uuid,
    futures, async-trait, serde, station_iface path dep)
    - build.rs: prost_build compiles protobufs/sim/world.proto to OUT_DIR
    - src/lib.rs: module declarations, SimulationRuntime re-export
    - src/proto/mod.rs: include!(concat!(OUT_DIR, ...)) for the
    generated norma_sim.world.v1 types
    - stubs for clock, errors, snapshot_broker, actuation_sender,
    registry, health, supervisor, runtime (filled in later tasks)
    - backend/{mod, mock, runtime_dir, transport}.rs stubs
    - ipc/{mod, framing, codec, hand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
    [build.rs, errors.rs]
2026-04-11 station-iface: host SimRuntimeConfig + SimMode + LogCapture
    Adds the SimulationRuntime subsystem config types to the existing
    config-layer crate (instead of sim-runtime), resolving a potential
    circular dependency: sim-runtime depends on station-iface for the
    StationEngine trait, and station-iface in turn hosts the top-level
    Config struct that must be able to embed SimRuntimeConfig (see
    station-sim.yaml / station-shadow.yaml in Chunk 8).
    Three types:
    - SimMode { Internal, External }
    - LogCapture { File(default), Inherit, Null }
    - SimRuntimeConfig with serde rename_all = "kebab-case"-ish
    fields (socket-path, runtime-dir, startup-timeout-ms,
    shutdown-timeout-ms, log-capture, log-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
2026-04-11 sim-runtime: add SimRuntimeError enum
    Nine variants covering every operational failure the subsystem can
    emit:
    - RuntimeDirCreate / BackendSpawn (startup path)
    - HandshakeTimeout / ProtocolMismatch{ours,theirs} (handshake)
    - BackendCrashed / IpcClosed (runtime)
    - ConfigValidation / NormfsError (orchestration)
    - Backpressure (reliable-lane overflow)
    All derive thiserror::Error for downstream `?` ergonomics.
    Task 3.3 of Chunk 3.
    [errors.rs]
2026-04-11 sim-runtime: add clock helpers
    Three helpers:
    - new_session_id() — uuid::Uuid::new_v4() as string; stable ID
    for a SimulationRuntime instance lifetime.
    - world_tick_to_sim_time_ns(tick, timestep_ns) — saturating mul
    derivation of sim_time_ns from the canonical world_tick.
    - current_wall_ns() — SystemTime::now() relative to UNIX epoch,
    Station's own wall clock reference (cross-process comparison
    with the sim backend's wall clock is forbidden by architecture).
    Two tests: session IDs are unique, tick→time arithmetic matches
    the spec (0→0, 5 ticks × 2 ms timestep = 10 ms).
    Task 3.4 of Chunk 3.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
2026-04-11 sim-runtime: add WorldBackend trait (pub(crate))
    The WorldBackend trait represents the pluggable strategy the runtime
    uses to obtain a capability-keyed world simulation:
    - async start(startup_timeout) -> Result<BackendStarted>
    - async wait_terminated(self: Box<Self>) -> BackendTermination
    - async shutdown(grace) -> Result<()>
    BackendStarted carries the WorldDescriptor plus the two-ended mpsc
    IPC channel the snapshot broker and actuation sender attach to.
    BackendTermination { Clean, Crashed {exit_code, stderr_tail},
    KilledBySupervisor, SignaledByOs {signal} } is returned by
    wait_terminated so the supervisor can tag the runtime state.
    ARCHITECTURE INVARIANT — the trait MUST remain p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
    [mod.rs]
2026-04-11 sim-runtime: add TempRuntimeDir RAII
    A single temporary directory per SimulationRuntime session holds
    the UDS socket that Station and the sim backend share. Replaces the
    v1 spec's sentinel-file + lockfile + stale-socket state machine
    with a much simpler invariant: "the socket exists iff the runtime
    is ready".
    API:
    - create(parent, station_pid): builds the directory (default
    /tmp/norma-sim-<pid>) with unix mode 0o700 and returns the
    guard.
    - socket_path(): joins "sim.sock" to the directory.
    - path(): underlying path for introspection.
    - Drop: fs::remove_dir_all, tolerant of errors.
    Three tests:
    - test_create_and_drop_removes_dir (also verifies socket_path
    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
2026-04-11 sim-runtime: add UDS framing + transport helpers
    ipc/framing.rs:
    framed_unix_stream(stream) wraps a UnixStream in a tokio_util
    LengthDelimitedCodec with u32 big-endian length prefix and a
    16 MiB max frame length (headroom for full-res camera frame
    on top of an 8-joint snapshot).
    backend/transport.rs:
    spawn_transport(stream) splits the framed stream and launches
    two tokio tasks:
    outbound: out_rx → prost::encode → sink
    inbound: stream → prost::decode → in_tx
    Returns the two channel halves (cap 256, matches plan §6.4
    QoS-lane buffering).
    Outbound drops on encode failure (rare) or peer close.
    Inbound drops malformed individual frames but keeps the stream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
2026-04-11 sim-runtime: add Envelope codec with roundtrip tests
    Thin wrappers:
    encode_envelope(env) -> Vec<u8> (pre-allocates encoded_len() so
    prost::encode cannot fail)
    decode_envelope(bytes) -> Result<Envelope, prost::DecodeError>
    Two tests:
    test_hello_roundtrip — constructs Envelope { payload: Some(Hello) },
    encodes, decodes, verifies all three Hello fields.
    test_goodbye_roundtrip — same shape with Goodbye { reason: "bye" }.
    These guard against accidental schema drift: if world.proto is edited
    in a way that silently changes field tags or the Envelope oneof
    structure, these tests will fail immediately.
    Task 3.8 of Chunk 3.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
2026-04-11 sim-runtime: add MockBackend (#[cfg(test)]) for unit tests
    In-process fake WorldBackend for Chunks 3 and 4 unit tests. The
    whole file is #![cfg(test)] so the mock never ships in dev or
    release binaries.
    API (only used by tests in this crate):
    MockBackend::new(descriptor) — empty scripted_inbound, no observer
    scripted_inbound: Vec<Envelope> — drained to in_tx on start
    outbound_observer: Option<mpsc::Sender<Envelope>> — forwards
    everything the runtime sends so
    tests can assert on it
    WorldBackend impl:
    start(timeout): sets up two fresh mpsc channels (cap 256, matches
    transport.rs), drains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
2026-04-11 sim-runtime: add SnapshotBroker with multi-subscriber test
    Thin wrapper around tokio::sync::broadcast for fanning out
    WorldSnapshot instances to N in-process subscribers. Snapshots are
    wrapped in Arc so subscribers share the payload without copies.
    new(capacity) — builds the underlying broadcast channel
    publish(snapshot) — non-failing, no-op when no listeners
    subscribe() — broadcast::Receiver<Arc<WorldSnapshot>>
    Slow receivers lag per standard tokio broadcast semantics (Lag
    error on recv). That's acceptable because snapshots are the
    "lossy, latest-wins" lane of the subsystem — the reliable-control
    lane lives on the actuation sender (Task 4.2).
    Two tests: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
2026-04-11 sim-runtime: add ActuationSender with QoS lane routing
    Two-lane actuation forwarder (plan §6.4):
    LOSSY_SETPOINT lane:
    - mpsc capacity 256
    - try_send with drop-newest on full (logs warning)
    - matches real-time control convention that a fresh setpoint
    obsoletes a stale one
    RELIABLE_CONTROL lane:
    - mpsc capacity 32
    - awaits backpressure so discrete commands (torque enable,
    reset, one-shots) are never silently lost
    Construction spawns two forwarder tasks that unwrap batches into
    Envelope::Actuation and push to the shared outbound channel.
    send() dispatches on batch.lane via QosLane::try_from (prost 0.12
    idiom — mirrors st3215/src/state.rs:306 use of
    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
2026-04-11 sim-runtime: add WorldRegistry
    In-memory index of the WorldDescriptor returned by the backend's
    handshake. The runtime builds this once at startup and the compat
    bridge (Chunk 7) queries it by robot_id to resolve actuators.
    Fields:
    world_name: String
    robots: HashMap<String, RobotDescriptor>
    Methods:
    from_descriptor(desc): walks desc.robots, clones each into the map
    robot(id): O(1) lookup
    test_registry_from_descriptor — single robot lookup + miss
    test_registry_multi_robot — two robots, both findable
    Task 4.3 of Chunk 4.
    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
2026-04-11 sim-runtime: add HealthPublisher with /sim/descriptor + /sim/health queues
    HealthPublisher writes to two NormFS queues (§6.5) and mirrors
    SimHealth events to in-process broadcast subscribers:
    - sim/descriptor — exactly one WorldDescriptor per session,
    written on handshake completion. Enables offline replay of
    archived capability-keyed command logs by consumers that need
    to know the world topology the commands targeted.
    - sim/health — periodic SimHealth events (1 Hz in Chunk 4.8)
    for the web UI, the compat bridge, and external tooling.
    NormFS API (verified via
    software/drivers/st3215/src/driver.rs:37-45 — resolve() and
    ensure_queue_exists_for_write() pattern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
2026-04-11 sim-runtime: add ChildProcessBackend (spawn + handshake)
    Default WorldBackend for SimMode::Internal. Owns a TempRuntimeDir,
    spawns a subprocess (typically `python3 -m norma_sim ...`), waits
    for the UDS socket to appear, connects, and performs the client
    handshake — all inside a single `start()` call.
    Lifecycle:
    new(config, session_id)
    — stores launcher argv, session_id, log capture plan.
    start(timeout)
    1. Create TempRuntimeDir (/tmp/norma-sim-<station_pid>, 0o700)
    2. Resolve LogCapture → stdio (File | Inherit | Null)
    3. Spawn child with kill_on_drop + env NORMA_SIM_SOCKET_PATH,
    NORMA_SIM_SESSION_ID
    4. Poll socket_path.exists() every 50 ms up to startup_t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
    [mod.rs]
2026-04-11 sim-runtime: add ExternalSocketBackend
    Simpler WorldBackend for SimMode::External — no subprocess
    ownership. The developer runs `python -m norma_sim --socket X` in
    one terminal and points Station at the same path via
    station-sim-external.yaml.
    start(timeout):
    - UnixStream::connect to the pre-existing path
    - spawn_transport + perform_client_handshake using startup_timeout
    as the handshake window
    - return BackendStarted
    wait_terminated(self):
    - No child process to observe. Blocks on an internal Notify until
    shutdown() calls notify_waiters(), then returns Clean. This
    matches the "co-hosted dev" semantics — the external process
    outlives the sim-runtime session.
    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
2026-04-11 sim-runtime: implement SimulationRuntime public API (5-substep split)
    The public façade for the whole sim subsystem. Replaces the Chunk 3
    Task 3.1 stub `pub struct SimulationRuntime;` with the real
    field-bearing struct + async constructors + method surface.
    registry — WorldRegistry built from the handshake descriptor
    descriptor — cached for `world_descriptor()` lookups
    broker — Arc<SnapshotBroker> fed by the dispatch loop
    actuation — Arc<ActuationSender> wrapping the outbound channel
    health — Arc<HealthPublisher> for sim/descriptor + sim/health
    session_id — carried into every SimHealth event
    _dispatch_task — Join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
2026-04-11 sim-runtime: add integration tests for start + actuation + shutdown
    Four integration tests that exercise the full SimulationRuntime
    pipeline via start_with_backend + MockBackend:
    1. test_runtime_start_succeeds_and_exposes_descriptor
    - start_with_backend returns Ok
    - world_descriptor().world_name matches the mock's descriptor
    - publish_hz forwarded through the handshake
    2. test_runtime_multi_subscriber_fan_out
    - two subscribe_snapshots() receivers both alive
    - smoke test of the broker plumbing (the snapshot_broker unit
    tests cover the semantics, this verifies the dispatch loop
    wires the broker into SimulationRuntime)
    3. test_runtime_actuation_ro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
2026-04-11 sim-runtime: fix CI invariant false-positives in doc comments
    Two comment strings inside sim-runtime/src/ literally mentioned
    the legacy servo driver's crate name as part of cross-reference
    citations, which would trip Chunk 8's CI check:
    grep -ri "st3215" software/sim-runtime/src/ # must be empty
    Rewrote both without using the literal name (same cosmetic fix
    previously applied to st3215-wire/src/lib.rs in Chunk 2):
    src/health.rs: "software/drivers/st3215/src/{driver,state}.rs"
    → "the existing servo-bus driver crate under
    software/drivers/"
    src/actuation_sender.rs: "st3215/src/state.rs:306"
    → "the existing servo-driver crate'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
2026-04-11 sim-server: create norma_sim package skeleton with pyproject.toml
    New top-level directory software/sim-server/ hosts the Python
    simulation server that sim-runtime's ChildProcessBackend launches
    as a subprocess (SimMode::Internal) or developers run standalone
    via `python -m norma_sim ...` (SimMode::External).
    Layout:
    pyproject.toml — name=norma-sim, mujoco>=3.2,<4, numpy,
    protobuf, pyyaml; dev extras pytest/ruff/mypy
    README.md — stub (smoke-test checklist lands in Chunk 8)
    norma_sim/
    __init__.py — version 0.1.0
    world/__init__.py
    scheduler/__init__.py
    ipc/__init__.py
    tests/
    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
2026-04-11 sim-server: add JsonFormatter logging setup
    Stdlib logging formatter (spec §12.3) that emits single-line JSON
    on stderr so the Rust ChildProcessBackend can tee to a log file
    and downstream tooling parses with no heuristics.
    ts ISO-8601 UTC with microseconds
    level logging level name
    component logger name
    msg the formatted message
    exc exception traceback (when logger.exception is used)
    <extras> merged from LogRecord.extra_fields dict (optional)
    configure_logging(level) installs a single stderr handler on the
    root logger, replacing any existing handlers so CLI entry points
    (Chunk 6 Task 6.5) can call it idempotently.
    Four unit tests (pytest)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
2026-04-11 sim-server: add world.manifest with source_hash verification
    Frozen dataclass hierarchy that mirrors the yaml schema in
    hardware/elrobot/simulation/worlds/elrobot_follower.world.yaml:
    WorldManifest
    scene: SceneConfig (timestep, gravity, integrator, solver, iter)
    robots: tuple[RobotManifest, ...]
    actuators: tuple[ActuatorManifest, ...]
    capability: ActuatorCapability (kind + optional limits)
    gripper: Optional[GripperMeta]
    primary_joint_range_rad
    normalized_range
    mimic_joints: tuple[GripperMimic, ...]
    sensors: tuple[SensorManifest, ...]
    urdf_path / mjcf_path: resolved to absolute Paths
    load_manifest(path) performs the yam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
2026-04-11 sim-server: add capabilities module + P0 gripper roundtrip test
    ★ SOLE capability semantics module (plan §5.4). When we add a new
    capability kind we edit exactly this one file; everything else
    (actuation.py, snapshot.py, descriptor.py) delegates here.
    Two functions, inverses of each other:
    command_value_to_ctrl(value, actuator):
    REVOLUTE_POSITION / PRISMATIC_POSITION → identity
    GRIPPER_PARALLEL → linearly interpolate
    value ∈ normalized_range → ctrl ∈ primary_joint_range_rad
    Unknown kind → ValueError
    qpos_to_position_value(qpos, actuator):
    The inverse of the above. Used by the snapshot builder to
    translate raw MuJoCo qpos back into the client-facing
    capabil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
2026-04-11 sim-server: add MuJoCoWorld wrapper
    Thin owning handle around mujoco.MjModel/MjData plus manifest-
    driven indexing. Higher-level behaviour (ActuationApplier,
    SnapshotBuilder) takes a MuJoCoWorld by reference rather than
    re-doing name→id lookups on every call.
    MuJoCoWorld(manifest, verify_hash=True)
    — direct constructor when the caller already has a WorldManifest
    MuJoCoWorld.from_manifest_path(path, verify_hash=True)
    — canonical entry point used by CLI and tests: loads the yaml,
    verify_source_hash against the MJCF, constructs MjModel/MjData,
    builds the name-indexed caches
    actuator_id_for(mjcf_actuator) -> Optional[int]
    joint_qposadr_for(urdf_joint) -> O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
2026-04-11 sim-server: add world.descriptor builder (manifest → WorldDescriptor proto)
    Three new files plus a workaround for a dev-env namespace
    conflict.
    1. norma_sim/world/_proto.py — import shim that resolves the repo
    root by walking up from its own Path, inserts it at the front
    of sys.path, then imports the gremlin-generated
    `target.gen_python.protobuf.sim.world` module as `world_pb`.
    Every other norma_sim module imports proto types from here,
    keeping the sys.path mutation in a single location. If the
    build pipeline later switches from gremlin_py to google.protobuf
    bindings, only this file needs to change.
    2. norma_sim/world/descriptor.py — build_world_descriptor(manife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
2026-04-11 sim-server: add ActuationApplier (proto batch → data.ctrl writes)
    ActuationApplier.drain_and_apply(batch) walks ActuationCommand
    entries, resolves each to an (ActuatorManifest, ctrl_idx) pair via
    a cached id→mjcf_name map, converts the set_position value via
    capabilities.command_value_to_ctrl, and writes data.ctrl[idx].
    MVP-1 intent handling:
    set_position → apply via capabilities (normalized → rad for
    GRIPPER_PARALLEL, identity for revolute/prismatic)
    disable_torque→ park ctrl at the current qpos so the position
    controller holds position (pragmatic MVP-1 stand-in
    for a proper torque-off mode)
    other intents → log warnin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
2026-04-11 sim-server: add SnapshotBuilder (MjData state → WorldSnapshot proto)
    SnapshotBuilder(world) pre-computes a cached row list
    (robot_id, actuator_id, ctrl_idx, qpos_addr, ActuatorManifest) at
    construction time so build() stays cheap at 100 Hz publish rates.
    build(clock) walks the cached rows once per frame:
    - reads data.qpos[qpos_addr] → capabilities.qpos_to_position_value
    produces position_value in the client-facing unit (rad for
    revolute, [0..1] for GRIPPER_PARALLEL)
    - reads data.ctrl[ctrl_idx] → capabilities.qpos_to_position_value
    produces goal_position_value in the same unit
    - velocity_value / effort_value stubbed to 0.0 for MVP-1
    - torque_enabled defaults True, m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
2026-04-11 sim-server: add P0 mimic gripper test (pytest)
    Port of the Chunk 1 Task 1.7 one-off demo into the pytest tree
    where CI can keep it green. Two tests (tests/world/test_mimic_gripper.py):
    1. test_mimic_gripper_equality_works ★ P0
    - Loads the Chunk 1 generated MJCF
    - Drives act_motor_08 ctrl to 1.0 rad
    - Steps 5000 × 2 ms (10 s of sim) — the gripper's kp=10 settles
    slowly, 500 steps (plan's number) leaves the motor around
    0.625 rad instead of 0.94, see commit a76b2fe for the
    tendon-equality fix that enabled this convergence at all
    - Asserts motor 8 within 0.1 of target and both mimic joints
    track the 0.0115 m/rad ratio to within 0.002 m
    2. test_mimic_grippe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
2026-04-11 sim-server: add WorldScheduler protocol + RealTimeScheduler
    Two new files plus four tests implementing the §8.3-8.4 scheduler
    contract. The simulation loop is the one place where wall clock
    meets sim time, so getting pacing right matters for the whole
    subsystem.
    scheduler/base.py:
    - WorldScheduler Protocol with run_forever/stop/tick properties.
    Different policies (real-time, fast, determinism) can slot in.
    scheduler/realtime.py:
    - RealTimeScheduler(world, physics_hz=500, publish_hz=100,
    on_publish=callable)
    - Deadline for tick N is t0_wall_ns + N * physics_ns (anchored,
    NOT last_deadline + physics_ns, so catch-up never drifts)
    - If slack_ns > 0 → sleep. If slack_ns <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
2026-04-11 sim-server: add ipc.framing with 1MB boundary test
    Async length-delimited framing for the asyncio UDS transport:
    read_frame(reader) -> bytes
    4-byte big-endian u32 length prefix, then exact payload.
    Rejects length > 16 MiB to protect against OOM on malformed
    peers. Matches the Rust sim-runtime's tokio_util
    LengthDelimitedCodec in sim-runtime/src/ipc/framing.rs so the
    cross-language wire format is identical.
    write_frame(writer, payload) -> None
    Writes header + payload and awaits drain. No-op body for an
    empty payload.
    Four tests (tests/ipc/test_framing.py). Due to PEP 668 we can't
    `pip install pytest-asyncio` in this dev env, so each test is a
    plain sync func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
2026-04-11 sim-server: add ipc.codec with verified proto import path
    encode_envelope/decode_envelope wrappers around the gremlin_py
    generated Envelope, imported via the existing norma_sim.world._proto
    shim (so there's still exactly one place that touches sys.path).
    Design choices forced by gremlin_py's reader API:
    - Encoding is cheap: `envelope.encode()` returns bytes.
    - Decoding goes through EnvelopeReader(memoryview) because
    gremlin_py has no top-level "parse to dataclass" helper. The
    Reader is lazy: fields are only parsed when get_<field> is
    called. We materialise the full Envelope dataclass eagerly so
    the session/server code can use normal attribute access.
    - Oneof presence: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
2026-04-11 sim-server: add ipc.session with handshake + reader/writer
    ClientSession wraps one asyncio UDS connection on the server side.
    IpcServer constructs one per accepted client and hands it a
    per-session snapshot_queue that the scheduler writes into.
    run()
    1. _handshake(): read one frame, expect Hello with
    protocol_version == 1. Reply with a Welcome carrying the
    WorldDescriptor. Wrong version or missing Hello → send an
    Error{E_PROTOCOL_VERSION} and return False.
    2. asyncio.gather(reader_loop, writer_loop).
    _reader_loop(): decode inbound frames in a loop. Route:
    ActuationBatch → on_actuation(batch) callback (server passes
    a closure into th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
2026-04-11 sim-server: add ipc.server asyncio UDS server with fan-out
    IpcServer orchestrates the Python side of the sim-runtime IPC:
    start()
    - unlink any stale socket file (leftover from a crashed run)
    - asyncio.start_unix_server on self.socket_path
    - chmod the socket to 0o600 (user-private)
    _handle_client(reader, writer)
    - mint a uuid4 session_id
    - create per-session snapshot_queue (cap 32)
    - construct ClientSession and register it
    - await session.run(); unregister on exit
    - sessions list protected by an asyncio.Lock (async-safe)
    broadcast_snapshot(snap)
    - iterate a snapshot of the current sessions list (avoids
    holding the lock during put_nowait)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
2026-04-11 sim-server: add CLI + __main__ entry point
    `python -m norma_sim --manifest <path>` is the canonical entry
    point that sim-runtime's ChildProcessBackend launches
    (SimMode::Internal) and that developers run standalone
    (SimMode::External).
    Flags:
    --manifest required, path to world.yaml
    --socket UDS bind path; falls back to $NORMA_SIM_SOCKET_PATH
    (the env var that ChildProcessBackend sets)
    --physics-hz default 500
    --publish-hz default 100
    --log-level default INFO (wires into configure_logging
    JsonFormatter on stderr)
    Startup sequence:
    1. Load + source_hash verify manifest
    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
2026-04-11 sim-server: add probe_manifest.py diagnostic tool
    No-network helper that loads a world manifest, verifies its MJCF's
    source_hash, builds the WorldDescriptor proto, and prints a
    human-readable summary. Useful for checking that gen.py produced
    a consistent state without having to boot the full sim server.
    Example run against the Chunk 1 manifest:
    world_name: elrobot_follower_empty
    urdf_path: .../hardware/elrobot/simulation/elrobot_follower.urdf
    mjcf_path: .../hardware/elrobot/simulation/worlds/elrobot_follower.xml
    scene.timestep: 0.002s
    ...
    source_hash OK (elrobot_follower.xml)
    robots (1):
    elrobot_follower
    actuators (8):
    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
2026-04-11 sim-server: add inspect.py diagnostic tool
    Interactive inspector that connects to a running norma_sim over
    its UDS, performs the handshake, and prints each WorldSnapshot
    as it arrives. Output format per actuator:
    rev_motor_01 pos=+0.0000 goal=+0.5000 tq_on=1 moving=0
    --socket required, UDS path the sim is bound to
    --limit N exit after N snapshots (default: run until Ctrl+C)
    --client-id cosmetic identifier sent in Hello (default:
    "inspect-cli")
    Error handling:
    - socket not found → print error, exit 1
    - Welcome-reply-is-Error → print code+message, exit 2
    - connection closed mid-stream → print notice, exit 0
    - Ctrl+C → exit 0
    Use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
2026-04-11 sim-server: add send_actuation.py diagnostic + rename inspect.py → inspect_sim.py
    send_actuation.py is a one-shot CLI that connects to a running
    norma_sim, does the handshake, sends a single ActuationBatch
    built from flags, then exits. Handy for smoke-testing actuation
    routing without writing a full client.
    --socket required, UDS path
    --robot required, robot_id (e.g. elrobot_follower)
    --actuator required, actuator_id (e.g. rev_motor_01)
    --value required, set_position value (rad for revolute,
    [0..1] for GRIPPER_PARALLEL)
    --lane 'lossy' | 'reliable', defaults to 'lossy'
    Also renames scripts/inspect.py → scripts/inspect_sim.py. Running
    the o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
2026-04-11 sim-server: add integration tests for full loop + multi-client fan-out
    Three subprocess integration tests (tests/integration/test_full_loop.py)
    that launch a real `python -m norma_sim` and exercise the full
    lifecycle. They use asyncio.create_subprocess_exec with a manually
    assembled PYTHONPATH so the child sees both the norma_sim package
    and the repo root (for shared.gremlin_py + target.gen_python).
    1. test_full_loop
    - spawn sim, wait for socket, handshake, send one
    set_position on rev_motor_01, read up to 30 frames looking
    for a snapshot with actuators populated
    - asserts world_name == elrobot_follower_empty in the Welcome
    - asserts at least one snapshot carries actuator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
2026-04-11 st3215-compat-bridge: create crate skeleton
    New workspace member software/sim-bridges/st3215-compat-bridge/.
    Layout follows the Chunk 2 st3215-wire / Chunk 3 sim-runtime pattern:
    Cargo.toml
    deps:
    - sim-runtime (path, public API only)
    - st3215-wire (path, pure-protocol types for pack/unpack
    and RamRegister addresses)
    - station_iface (path, bridge config + StationEngine trait
    + COMMANDS_QUEUE_ID)
    - st3215 (path, for st3215_proto::Command — real
    driver crate pulled in because the
    generated prost types live inside it; the
    alternat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
2026-04-11 station-iface: add St3215CompatBridgeConfig + Bridges with sim:// prefix enforcement
    Same circular-dep-avoidance pattern as Chunk 3's SimRuntimeConfig:
    the config types live in station_iface so both station (the
    embedder of Config) and st3215-compat-bridge (the consumer) can
    depend on them without creating a cycle.
    New types (software/station/shared/station-iface/src/config.rs):
    St3215CompatBridgeConfig
    enabled: bool
    robot-id: String (which robot in the sim world this
    bridge presents as a legacy bus)
    preset-path: PathBuf (yaml with per-motor id/offset/limits)
    legacy-bus-serial: String
    validate() enforces ONE structural invariant: l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
    [config.rs, lib.rs]
2026-04-11 st3215-compat-bridge: add preset_loader + elrobot-follower.yaml
    presets/elrobot-follower.yaml lists the 8 motors the bridge
    presents as a legacy ST3215 bus:
    rev_motor_01..07 motor_id 1..7, offset_steps 2048 (centered in
    the [0,4095] step range so 0 rad = 2048 steps)
    rev_motor_08 motor_id 8, offset_steps 0 (gripper primary
    starts at 0 rad, URDF upper_limit=2.2028 rad)
    legacy_bus_serial: "sim://bus0" — the sim:// prefix is required
    by both preset_loader::load_preset and the config validator added
    in Task 7.2, so misconfiguration fails fast at load time.
    preset_loader.rs API:
    RobotPreset { robot_id, legacy_bus_serial, motors: Vec<MotorEntr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
    [elrobot-follower.yaml]
2026-04-11 st3215-compat-bridge: add ActuatorMap
    Bidirectional lookup table between motor_id (u8) and actuator_id
    (String) for one preset. Built once at bridge startup and queried
    on every inbound ST3215 command and outbound WorldSnapshot entry,
    so the O(1) HashMap lookups matter for the snapshot path at
    publish_hz=100.
    from_preset(&RobotPreset) — build both directions
    get_by_motor_id(u8) → Option<&MotorEntry>
    get_motor_id_by_actuator(&str) → Option<u8>
    len() / is_empty() — sanity for tests + startup
    validation (Task 7.8)
    Two tests (actuator_map::tests):
    - test_bidirectional_lookup — 2 mot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
2026-04-11 st3215-compat-bridge: add command_task with verified protobuf shapes + translation tests
    The critical compat piece: translates legacy ST3215 byte-level
    commands on the global `commands` queue into capability-keyed
    ActuationBatches the sim runtime accepts.
    spawn_command_task(normfs, sim_runtime, actuator_map, robot_id,
    legacy_bus_serial) subscribes to COMMANDS_QUEUE_ID ("commands")
    with a callback that:
    1. Decodes StationCommandsPack
    2. Filters to StationCommandType::StcSt3215Command
    3. Decodes body as st3215_proto::Command
    4. Filters by target_bus_serial == legacy_bus_serial (required
    in shadow mode where the real driver also subscribes)
    5. Calls translate_command(...) (pure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
2026-04-11 st3215-compat-bridge: add state_task (WorldSnapshot → st3215/inference bytes)
    spawn_state_task subscribes to SimulationRuntime::subscribe_snapshots
    and, for each WorldSnapshot, builds and enqueues the exact byte
    payload legacy clients observe on `st3215/inference`.
    Pipeline per snapshot:
    1. For each ActuatorState:
    - filter by robot_id
    - look up motor_id via ActuatorMap.get_motor_id_by_actuator
    - look up MotorEntry via ActuatorMap.get_by_motor_id
    - build MotorSemanticState from position/velocity/effort/
    torque_enabled/moving/goal_position_value
    - pack_state_bytes(motor_id, ST3215_STANDARD, instance, state)
    produces the 71-byte wire format
    2. Assem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
2026-04-11 st3215-compat-bridge: add health_task (offline marker on backend termination)
    spawn_health_task subscribes to SimulationRuntime::subscribe_health
    and watches for backend_alive=false. On termination:
    - log::error with bus serial and termination cause so operators
    can diagnose the drop without digging through sim-runtime logs
    - exit the task (its JoinHandle is owned by BridgeHandle)
    MVP-1 deliberately stops short of writing a synthetic offline
    marker to `st3215/meta`. The exact format requires cross-
    referencing the legacy St3215Bus shape, which belongs to the
    existing driver's domain, and the legacy-bus-serial that never
    reappears is signal enough for clients today. Proper offline
    m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
    [health_task.rs]
2026-04-11 st3215-compat-bridge: add lib.rs entry + startup validation
    start_st3215_compat_bridge(normfs, engine, sim_runtime, config)
    is the public entry point Station's main.rs calls during startup
    (Chunk 8 Task 8.4). Steps:
    1. config.validate() — enforces sim:// prefix on legacy_bus_serial
    2. load_preset() — parses + validates the yaml preset file
    3. Verify config.robot_id is in sim_runtime.world_descriptor()
    (returns BridgeError::RobotNotInWorld otherwise)
    4. Verify every preset motor.actuator_id is a declared actuator
    on that robot (returns BridgeError::ActuatorNotInWorld)
    5. Build ActuatorMap
    6. Spawn command_task (inbound legacy → sim-runtime actuation)
    7. Spawn st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
2026-04-11 station-iface: add Config::validate() with no mutual exclusion
    Extends the top-level Config struct with two new fields and a
    validate() entry point so both sim-runtime and the compat bridge
    can be configured declaratively through the station yaml.
    New fields on Config:
    sim-runtime: Option<SimRuntimeConfig> (Chunk 3 type)
    bridges: Bridges { st3215_compat: Option<...> } (Chunk 7 type)
    Both are optional and skipped during serialisation when empty, so
    existing station yamls load unchanged.
    Config::validate() enforces:
    1. If sim-runtime is present → its own validate() passes
    (mode=internal needs launcher, mode=external needs socket-path)
    2. If bridges.st3215_compat.enabled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
    [config.rs]
2026-04-11 station: add sim-runtime + st3215-compat-bridge deps
    Path dependencies added to the station binary Cargo.toml so Task
    8.4's main.rs wiring can reach the public APIs:
    sim-runtime → SimulationRuntime + SimRuntimeError
    st3215-compat-bridge → start_st3215_compat_bridge + BridgeHandle
    cargo build -p station → green (with station-viewer/dist built in
    Task 8.0). The existing st3215 driver dep stays in place — the
    sim bridge coexists with, not replaces, the real driver.
    Task 8.3 of Chunk 8.
2026-04-11 station: wire SimulationRuntime + st3215-compat-bridge into main.rs
    Adds three new Station methods and wires them into the main()
    startup + shutdown sequence, plus the Config::validate() call.
    Station struct gains:
    sim_runtime: parking_lot::Mutex<Option<Arc<SimulationRuntime>>>
    bridges: parking_lot::Mutex<Vec<Arc<BridgeHandle>>>
    New methods (Station impl):
    start_sim_runtime()
    - Skips with an info log when config.sim_runtime is None or
    enabled=false
    - Otherwise clones the SimRuntimeConfig, casts self.engine to
    Arc<dyn StationEngine>, calls SimulationRuntime::start
    - Stores the runtime in self.sim_runtime
    - Logs the world_descriptor().world_name on succ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
    [main.rs]
2026-04-11 station: add sim scenario yamls (sim / external / shadow)
    Three config files under software/station/bin/station/:
    station-sim.yaml — Scenario A (internal sim only)
    - sim-runtime mode=internal with a full `python3 -m norma_sim`
    launcher argv
    - st3215_compat bridge on `sim://bus0`
    - drivers.st3215 and usb-video both disabled
    - one inference entry targeting sim://bus0
    This is the canonical "no hardware / no debugging" demo config.
    station-sim-external.yaml — Scenario B (external sim)
    - sim-runtime mode=external with socket-path=/tmp/norma-sim-dev.sock
    - same bridge config as scenario A
    - Station does NOT own the sim subprocess lifecycle; a developer
    runs `python -m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
2026-04-11 build: add sim Makefile targets + check-arch-invariants
    Six new Makefile targets:
    sim-run Launch station -c station-sim.yaml (scenario A,
    fully internal, Station owns the norma_sim child)
    sim-standalone Launch `python3 -m norma_sim` bound to
    /tmp/norma-sim-dev.sock (for scenario B)
    sim-external Launch station -c station-sim-external.yaml
    (connects to the standalone from sim-standalone)
    sim-shadow Launch station -c station-shadow.yaml
    (real driver + sim coexistence)
    sim-test cargo test -p {st3215-wire,sim-runtime,
    st3215-compat-bridge} followed by pytest for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
2026-04-11 gitignore: ignore sim runtime artifacts + viewer build + .context/
    Added entries:
    Sim runtime state:
    /tmp/norma-sim* TempRuntimeDir sockets (cleaned on
    normal shutdown but Ctrl+C crash paths
    may leave them behind)
    sim-backend.log
    sim-runtime.log
    station_data/sim-*.log
    Session-local:
    .context/ codex-review session pointer that has
    been showing as untracked in every git
    status since the spec-review loop
    (commit 50cf629)
    Yarn/viewer artifacts (Task 8.0 built the dist tree):
    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
2026-04-11 station: add cross-crate E2E test for legacy station_py compat
    Two tokio integration tests in software/station/bin/station/tests/
    sim_integration.rs that prove the whole Chunk 1 → Chunk 7 pipeline
    actually closes on legacy ST3215 commands without the client side
    needing any modification. This is codex's explicit acceptance
    criterion for the v2 compat story.
    test_legacy_station_py_commands_flow_through_bridge ★★★
    - tempdir NormFS + no-op StationEngine + MockBackend with a
    canned WorldDescriptor covering all 8 motors in the bridge
    preset
    - SimulationRuntime::start_with_mock (exposed via the sim-runtime
    `test-util` feature flag added in this commit) gives us the
    rea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
2026-04-11 sim-server: write README with manual smoke-test checklist
    Replaces the Chunk 5 stub README with full content:
    - Installation via PYTHONPATH (PEP 668 documented)
    - Standalone scenario B command
    - Scenario A manual smoke-test checklist with 7 steps,
    the ★ P0 gripper demo (drag motor 8 slider → Gripper jaws
    open/close via the tendon-based MJCF equality from Chunk 1
    a76b2fe) as step 6
    - Troubleshooting notes for each likely failure mode
    - High-level architecture recap pointing at the v2 spec and
    the three crates (sim-runtime, norma_sim, st3215-compat-bridge)
    This is the document Task 8.11's automated smoke test substitutes
    the manual browser checklist with.
    Task 8.9 of Chunk 8.
    C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
2026-04-11 sim: MVP-1 simulation integration complete
    Implements the full v2 simulation integration design across 8 chunks:
    Chunk 1: Proto schema + world.yaml manifest + gen.py MJCF derivation
    with tendon-based gripper mimic equality (7 commits)
    Chunk 2: st3215-wire pure-protocol crate (migrated from the real
    driver) + pack_state_bytes + P0 roundtrip test (7 commits)
    Chunk 3: sim-runtime foundation — config, errors, clock, WorldBackend
    trait (pub(crate)!), transport, framing, codec, handshake,
    mock backend (10 commits)
    Chunk 4: sim-runtime subsystem — SimulationRuntime public API,
    ChildProcess + ExternalSocket backends, snapshot broker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
2026-04-11 Cargo.lock: record st3215-wire + tempfile dev-deps for station
    Task 8.8 added sim-runtime (features=test-util), st3215-wire, and
    tempfile to software/station/bin/station/Cargo.toml's
    [dev-dependencies] but the resulting Cargo.lock update was not
    committed in 5491c0d. Adding the refreshed lockfile.
2026-04-11 sim-server: install signal handlers before server.start to fix shutdown race
    Chunk 8 Task 8.11's automated smoke test + Chunk 6's
    test_subprocess_clean_shutdown integration test both exhibit a
    flaky failure where /tmp/norma-sim*/sim.sock lingers after
    SIGTERM. Root cause: cli.py installed the asyncio signal
    handlers AFTER calling server.start(), so a SIGTERM arriving
    during the gap between `await server.start()` and the handler
    registration killed the process with Python's default handler,
    never running IpcServer::stop() which is what unlinks the
    socket.
    Fix: move the signal-handler registration block to immediately
    BEFORE `await server.start()`. The _request_stop_event + handle
    closure now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
2026-04-11 st3215-compat-bridge: register inference queue with station engine
    The state task was writing InferenceState bytes into normfs under
    `st3215/inference`, but never called `engine.register_queue`. This
    meant station's `Inference` aggregator (bin/station/src/inference/)
    never subscribed to the bridge's queue and the `InferenceRx` packet
    that the web UI reads for `inferenceState.st3215` was always empty.
    Result: after Chunk 8 integration the station-viewer showed "connect
    a robot" empty-state even though sim-runtime was producing snapshots
    and the bridge was writing to normfs correctly.
    Mirrors `software/drivers/st3215/src/driver.rs:54-59` so real-driver
    and sim-bridge expose the same shape to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
    [lib.rs, state_task.rs]
2026-04-11 sim: clippy cleanup across MVP-1 crates
    Zero-warning pass on sim-runtime / st3215-wire / st3215-compat-bridge /
    station_iface. Remaining workspace warnings are all in drivers/st3215
    and drivers/usbvideo — pre-existing, unrelated to MVP-1 scope.
    Fixes:
    - state_task.rs: move `ActuatorState` import into the `#[cfg(test)]`
    module (only used in test fixtures)
    - actuator_map.rs: mark `is_empty()` as `#[allow(dead_code)]` — kept
    as clippy's `len_without_is_empty` companion
    - registry.rs: annotate `WorldRegistry` struct + `robot()` getter as
    scaffolding for MVP-2's public `registry()` API
    - backend/mod.rs: `shutdown()` trait method + unused `BackendTermination`
    variants are MVP-2's expl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
    [actuator_map.rs, config.rs, mod.rs, state_task.rs]
2026-04-11 spec: MVP-2 Menagerie walking skeleton design
    Design spec for MVP-2, produced via superpowers:brainstorming 5-section
    iterative flow. Core architectural move: URDF-first → MJCF-first with
    MuJoCo Menagerie SO-ARM100 as fork source. Phase 0/1/2 walking skeleton
    structure independently validates two hypotheses:
    - Phase 1: MVP-1 Rust/IPC/bridge infra is robot-agnostic
    - Phase 2: Menagerie physics params transfer to ElRobot 8-joint topology
    Non-goals: gym/env wrapper, policy training, real hardware, leader arm,
    vision, gravity-comp control layer. Explicitly deferred to MVP-3+.
    Acceptance: 6 Floor (automated) + 2 Ceiling (manual) criteria.
    Addresses the M1 slider unresponsiveness physics debt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
2026-04-11 spec: MVP-2 — fix 2 internal contradictions from reviewer pass
    Spec-document-reviewer approved with minor recommendations. Two issues
    were clear internal contradictions worth fixing before user review:
    1. §3.2 (Ceiling item 8) used positional `mujoco.viewer <path>` while
    §9.5 manual checklist used `--mjcf <path>` flag form. Unified to
    positional form (shorter, matches modern mujoco.viewer CLI).
    2. §5.1 file tree said `worlds/ # 删除（或留空 README）` — a soft
    option contradicting §5.2's unambiguous delete. Removed the soft
    option; worlds/ is deleted as a whole.
    Other reviewer recommendations (Phase 0 time estimate, tuning budget
    surfacing in step list, scene_ove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
2026-04-11 plan: MVP-2 walking skeleton — Chunks 1-3 (approved)
    Implementation plan for MVP-2 Menagerie walking skeleton. First three
    chunks approved by plan-document-reviewer:
    - Chunk 1: Phase 0 reconnaissance + vendor (277 lines)
    - Chunk 2: norma_sim source migration — code only (1224 lines)
    - Chunk 3: norma_sim test-fixture migration (1089 lines)
    Chunk 2 rewrites load_manifest for the new .scene.yaml schema,
    removes source_hash machinery, and renames ActuatorManifest.urdf_joint
    to mjcf_joint (with cascade through model.py / actuation.py /
    snapshot.py / cli.py). Chunk 3 migrates all MVP-1 test files to
    menagerie_scene_yaml / elrobot_scene_yaml fixtures, closing the
    red window between schema mig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
2026-04-11 plan: MVP-2 walking skeleton — Chunks 4-7 (approved)
    Completes the MVP-2 implementation plan. All 7 chunks now in place,
    each approved by plan-document-reviewer:
    - Chunk 4: Phase 1 — walking skeleton configs + integration test
    - Chunk 5: Phase 2 — hand-written elrobot_follower.xml + worlds/ deletion
    - Chunk 6: Phase 2 — acceptance tests (6 Floor criteria + parametrized
    per-motor step response)
    - Chunk 7: Manual smoke test + docs + MVP-2 wrap-up (spec §3.4 DoD)
    Spec was also updated to use the correct preset path convention
    (presets/menagerie-so-arm100.yaml instead of src/menagerie_so_arm100.preset.yaml)
    to match the existing elrobot-follower.yaml layout.
    Plan total: 4216 lines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
2026-04-11 plan+spec: MVP-2 revisions from 2026-04-11 ecosystem research
    External research (via WebSearch + subagent) against the MuJoCo +
    lerobot ecosystem produced 3 concrete corrections to the MVP-2 plan:
    1. Menagerie trs_so_arm100 is confirmed 5-DOF (5 revolute + 1 gripper),
    not the 5-6 range the plan originally assumed. Last tuning 2025-06-09
    matched joint limits to real hardware. Menagerie has NO SO-101
    variant as of 2026-04. The upstream TheRobotStudio/SO-ARM100 has a
    6-DOF SO-101 MJCF, but it is auto-generated via onshape-to-robot and
    not hand-tuned (no usable armature values). Tightened Chunk 1 Task
    1.1 Step 4's expected output + added a topology gap warning.
    2. The ElRobot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
2026-04-11 plan+spec: Chunk 1 Task 1.1 amendments from Menagerie reconnaissance
    Task 1.1 implementer subagent confirmed MVP-2 structural assumptions
    with 2 actionable corrections:
    1. Inner MJCF filename is `so_arm100.xml`, not `trs_so_arm100.xml`.
    The directory stays `trs_so_arm100/` but the file inside drops the
    `trs_` prefix. Updated every reference across plan + spec.
    2. Menagerie's gripper is a plain single-DOF revolute joint + `<position>`
    actuator (name `Jaw`, axis `0 0 1`, range `-0.174 1.75`). NO tendon,
    equality, weld, or mimic — the simplest possible gripper. Updated
    Chunk 4 Task 4.1 to remove speculative "if tendon mimic" branches,
    and updated Chunk 5 Task 5.1 / spec §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
2026-04-11 vendor: import mujoco_menagerie trs_so_arm100 (MVP-2 Phase 0)
    Vendored from https://github.com/google-deepmind/mujoco_menagerie at
    commit c771fb04055d805f20db0eab6cb20b67555887d0 on 2026-04-11. Used
    as physics parameter reference for ElRobot's MVP-2 sim (see spec
    2026-04-11-mvp2-menagerie-walking-skeleton).
    Contents are byte-identical to upstream; see VENDOR.md for update
    procedure. License is Apache 2.0.
    Version: Standard Open Arm-100 5DOF - Version 1.3 (last tuning 2025-06-09)
2026-04-11 norma_sim: remove source_hash machinery (MVP-2 Chunk 2 Task 2.2)
    MVP-1 verified that a generated MJCF's embedded source_hash matched
    sha256(urdf_bytes + manifest_bytes). That was a safety net for the
    URDF → MJCF gen.py pipeline. Under MVP-2's MJCF-first architecture,
    MJCF is hand-written and the pipeline is deleted, so the hash check
    is meaningless.
    Removed:
    - verify_source_hash() function from manifest.py
    - hashlib / re imports (no other callers)
    - verify_source_hash import/call from model.py (plus verify_hash param)
    - verify_source_hash import/call from cli.py
    - 3 test_source_hash_* tests from test_manifest_load.py
    - verify_source_hash import from test_manifest_load.py
    Known "red windo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
2026-04-11 norma_sim: rename ActuatorManifest.urdf_joint → mjcf_joint (MVP-2 Chunk 2 Task 2.3)
    In MVP-2 there is no URDF in the sim path; the field stores the MJCF
    joint name that the actuator controls. Rename the field to match its
    MVP-2 semantic, and propagate through all source call sites: model.py
    (_build_lookups + joint_qposadr_for parameter), actuation.py,
    snapshot.py.
    _parse_actuator in manifest.py still reads raw["urdf_joint"] from the
    MVP-1 yaml format (transition support) but stores it in the renamed
    dataclass field. Task 2.5 will delete _parse_actuator entirely.
    test_capabilities.py still has `urdf_joint=` keyword arguments — that
    file is migrated in Chunk 3 Task 3.6.
2026-04-11 norma_sim: add _enumerate_mjcf_actuators helper (MVP-2 Chunk 2 Task 2.4)
    Returns (actuator_name, joint_name, type_tag) tuples by compiling the
    MJCF via mujoco.MjModel and reading actuator_gaintype / actuator_biastype
    / actuator_trnid. type_tag classifies <position> / <motor> / <general>
    so Task 2.5's load_manifest can auto-synthesize REVOLUTE_POSITION
    ActuatorManifest for unannotated <position> actuators. joint_name
    resolves the MJCF joint the actuator controls — used to populate
    ActuatorManifest.mjcf_joint without requiring yaml input.
    Tests run against Chunk 1's vendored Menagerie trs_so_arm100 (6
    actuators: Rotation, Pitch, Elbow, Wrist_Pitch, Wrist_Roll, Jaw).
2026-04-11 norma_sim: rewrite load_manifest for MVP-2 scene.yaml schema (Chunk 2 Task 2.5)
    The new schema:
    - world_name + mjcf_path required
    - scene_overrides optional (override MJCF <option>)
    - actuator_annotations optional; only for GRIPPER_PARALLEL or other
    non-default capabilities. Revolute actuators are synthesized from
    MJCF <position> enumeration (via _enumerate_mjcf_actuators).
    Replaces old _parse_actuator/_parse_sensor with:
    - _synthesize_revolute_actuator(mjcf_name, mjcf_joint)
    - _parse_annotated_actuator(ann, mjcf_joint)
    mjcf_joint comes from _enumerate_mjcf_actuators, not yaml — this is
    why Task 2.3 renamed ActuatorManifest.urdf_joint to mjcf_joint first.
    Gripper yaml placement matc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
2026-04-11 norma_sim: descriptor docstring + probe_manifest cleanup (MVP-2 Chunk 2 Task 2.6)
    descriptor.py: docstring note that sensors are empty in MVP-2 and
    urdf_path may be None. No behavior change — the existing list
    comprehension already iterates empty tuples correctly.
    probe_manifest.py: remove verify_source_hash import/call (deleted
    in Task 2.2), remove --no-verify-hash argparse option, delete the
    hash verification block + print line, handle urdf_path=None in the
    summary output, update module docstring.
    Without this cleanup, `python software/sim-server/scripts/probe_manifest.py`
    would ImportError at module load time because verify_source_hash no
    longer exists in manifest.py.
2026-04-11 norma_sim/tests: rewrite conftest.py for MVP-2 fixtures (Chunk 3 Task 3.1)
    Removes the old world_yaml_path + mjcf_path fixtures (which pointed
    at the deprecated worlds/elrobot_follower.* path) and replaces them
    with:
    - menagerie_mjcf_path + menagerie_scene_yaml — immediately usable
    (Chunk 1 vendored Menagerie SO-ARM100 scene.xml + we generate a
    minimal scene.yaml in tmp_path pointing at it)
    - elrobot_mjcf_path + elrobot_scene_yaml — skipped until Chunk 5 lands
    the hand-written ElRobot MJCF and scene.yaml
    Tests that currently use world_yaml_path/mjcf_path will still fail
    with a FixtureLookupError until the subsequent Chunk 3 tasks migrate
    them file-by-file.
2026-04-11 norma_sim/tests: migrate 5 tests/world files to MVP-2 fixtures (Chunk 3 Tasks 3.2-3.6)
    Split ElRobot-strict tests (nu==8, rev_motor_01..08 names, 2.2028 rad
    gripper range) from Menagerie-loose tests. ElRobot variants use
    elrobot_scene_yaml fixture which pytest.skips until Chunk 5 lands
    the hand-written elrobot_follower.xml. Menagerie variants use
    menagerie_scene_yaml and run immediately.
    Coverage split per file:
    - test_model.py: 4 ElRobot (skipped) + 3 Menagerie (passing)
    - test_snapshot.py: 3 ElRobot (skipped) + 2 Menagerie (passing)
    - test_actuation.py: 4 ElRobot (skipped) + 2 Menagerie (passing)
    - test_mimic_gripper.py: 2 ElRobot (skipped; P0 mimic tests are
    ElRobot-hardware-specific b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
2026-04-11 norma_sim/tests: migrate test_manifest_load + test_descriptor_build (Chunk 3 Tasks 3.7-3.8)
    test_manifest_load.py: rewrite the 3 remaining tests for MVP-2 .scene.yaml
    schema. Use tmp_path + menagerie_mjcf_path fixture for a real loadable
    Menagerie MJCF. The test_manifest_missing_gripper_fields_raises test
    discovers a real Menagerie actuator name via _enumerate_mjcf_actuators
    to avoid hardcoding.
    test_descriptor_build.py: full rewrite.
    - happy → split into _elrobot + _menagerie (world_name/robot_id/8-count
    assertions are ElRobot-specific; Menagerie variant uses default_robot
    and >= 5 actuators)
    - actuator_kinds → _elrobot only (2.94 / 4.71 are ElRobot hardware specs;
    no Menagerie a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
2026-04-11 norma_sim: migrate test_full_loop.py + update cli.py help (Chunk 3 Tasks 3.9-3.10)
    test_full_loop.py:
    - test_full_loop → elrobot_scene_yaml (ElRobot-strict, skipped until
    Chunk 5); world_name assertion updated to 'elrobot_follower'
    - test_multi_client_fan_out → menagerie_scene_yaml (robot-agnostic)
    - test_subprocess_clean_shutdown → menagerie_scene_yaml (robot-agnostic)
    - _spawn_sim helper parameter renamed world_yaml_path → scene_yaml_path
    (the --manifest CLI flag name is UNCHANGED)
    cli.py:
    - Module docstring + --manifest help text updated to reference
    MVP-2 .scene.yaml schema
    - Flag name `--manifest` preserved for backward compatibility
    with test_full_loop.py's _spawn_sim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
2026-04-11 norma_sim/tests: migrate remaining world_yaml_path → menagerie_scene_yaml (Chunk 3 followup)
2026-04-11 spec: MVP-2 Menagerie → ElRobot parameter comparison table
2026-04-11 mvp2: add elrobot_follower.scene.yaml pointing at hand-written MJCF
    [elrobot_follower.scene.yaml]
2026-04-11 mvp2: add M1-M7 actuator annotations to remap act_motor → rev_motor actuator_id
    [elrobot_follower.scene.yaml]
2026-04-11 mvp2: delete gen.py + worlds/ directory, repoint all references to scene.yaml
    The URDF → MJCF pipeline is no longer needed in MVP-2. elrobot_follower.xml
    is now hand-written at hardware/elrobot/simulation/elrobot_follower.xml
    (Chunk 5 Task 5.2). gen.py and its outputs in worlds/ are deleted.
    Repointed references to the new hardware/elrobot/simulation/elrobot_follower.scene.yaml
    location: Makefile sim-standalone target, station-sim.yaml, station-shadow.yaml,
    README.md example, manifest.py docstring, probe_manifest.py script.
    Makefile loses its regen-mjcf target.
    [elrobot_follower.world.yaml]
2026-04-11 docs: fix remaining README.md reference to deleted worlds/gen.py
    Task 5.5's atomic commit (b6b7c50) caught 6 of 7 references but missed a
    second occurrence in README.md's troubleshooting section. Replace the
    stale gen.py Phase 2c pointer with a direct reference to the hand-written
    elrobot_follower.xml's <tendon>/<equality> blocks.
2026-04-11 test: MVP-2 Phase 2 acceptance — 6 Floor criteria
2026-04-11 docs(sim-server): update manual smoke checklist for MVP-2
    Replace the MVP-1 "Scenario A smoke-test checklist" section with the
    MVP-2 version covering both Phase 1 (Menagerie walking skeleton) and
    Phase 2 (ElRobot 8-motor demo). Drops stale references to the deleted
    `make regen-mjcf` target and the pre-Menagerie `elrobot_follower_empty`
    log line.
    Also documents two empirical gotchas discovered during Task 7.1:
    1. PYTHONPATH=software/sim-server is load-bearing for station — without
    it the norma_sim subprocess silently fails to find its module and
    station hangs at "Starting sim-runtime" with no error.
    2. cargo build -p station needs station-viewer/dist/ to exist first;
    otherwise r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
2026-04-11 spec: MVP-3 Chunk 0 — Promote hardware/elrobot/simulation/ to first-class
    Design doc for the "一等公民 MJCF" restructure captured as a memory insight
    during MVP-2 Chunks 4-5 and deferred to MVP-3 Chunk 0.
    Specifies: target directory tree (models/, parameters/, tests/ subdirs +
    VERSION/README/CHANGELOG at root), 5 git moves, 8 content edits, 4 new
    files, and a single atomic commit on main. Execution approach chosen
    during brainstorming: direct-on-main (Approach 2) rather than worktree +
    subagent-driven-development, because scope is tight and risk is low.
    Explicit non-goals: no physics parameter tuning, no test splitting,
    no URDF relocation, no docs/ subdir. All deferred to MVP-3 Chunk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
2026-04-11 spec: amend MVP-3 Chunk 0 design with spec-review fixes
    Spec-document-reviewer iteration 1 found 2 blocking issues:
    1. Section 4.4 "load-bearing note" undercounted the old-conftest fixture
    consumers: 3 named (test_model, test_snapshot, test_descriptor_build)
    but actual is 4 — test_actuation.py also consumes elrobot_scene_yaml.
    Updated to name all 4 and explicitly note that test_mimic_gripper.py
    (the 5th current consumer) is moving out in this chunk.
    2. Commit message in Section 7 said "6 files with hardcoded paths
    repointed" but Section 4.4's authoritative table lists 7. The missing
    entry was software/sim-server/tests/conftest.py — the old conftest's
    elrobot_mjcf_p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
2026-04-11 spec: MVP-3 Chunk 0 — amend to three-tier structure per codex consult
    Codex consult (session 019d7726..., resumed from MVP-1 architectural
    review) exposed that the original spec conflated engine-native model
    assets with Norma-specific runtime manifests, and used surface-level
    "looks like Menagerie" organization without the boundaries that matter
    for future LeRobot / MJX / dataset pipeline integration.
    Core changes:
    1. Target directory tree reorganized into three concerns:
    - mujoco/elrobot_follower/ (engine-tier robot package, upstream candidate)
    - manifests/norma/ (Norma runtime wrappers — scene.yaml files)
    - assets/, vendor/, *.urdf (shared raw asset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
2026-04-11 spec: MVP-3 Chunk 0 — prune orphaned pre-amendment content
    Iteration 3 spec review caught that the previous amendment commit
    (0526679) left orphaned pre-amendment sections behind: Section 4's
    new 4.1-4.7 content was inserted but old 4.2-4.5 remained as a trailing
    duplicate, a duplicate 2.3 Non-goals appeared twice with contradicting
    content, and Section 5's new 5.1-5.9 left an orphaned old 5.7 behind.
    - Delete 299 lines of orphaned Section 4 content (old 4.2 through end
    of old 4.5) pointing at the pre-amendment flat models/ structure.
    - Delete duplicate Section 2.3 "No new tests" block that contradicted
    Section 2.1's two new test files (test_urdf_parity + test_mjx_compat).
    - De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
2026-04-11 mvp3: promote hardware/elrobot/simulation/ to three-tier first-class structure
    Chunk 0 of MVP-3: reorganize the ElRobot physics model into an engine-tier
    robot package (mujoco/elrobot_follower/) separate from Norma-side runtime
    manifests (manifests/norma/). Structure follows codex consult feedback
    (session 019d7726...) from the brainstorming stage, which exposed that the
    original "models/+parameters/+tests/ as one dir" plan conflated engine-
    native MJCF assets with Norma-specific wrapper metadata.
    New structure under hardware/elrobot/simulation/:
    mujoco/elrobot_follower/ ← NEW engine-tier robot package
    elrobot_follower.xml ← MOVED from simulation/ (+ meshdir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
    [elrobot_follower.scene.yaml, elrobot_follower.xml, robot.yaml]
2026-04-11 spec: MVP-3 Foundation roadmap (lean, 3-chunk decomposition)
    Defines MVP-3 Foundation as the natural continuation of Chunk 0: complete
    the engine-tier robot package by moving assets+urdf into the package
    (Chunk 1, A2), adding a Menagerie-style scene.xml wrapper (Chunk 2, A3),
    and rewriting test_elrobot_acceptance.py as pure-mujoco so it can move
    into the package (Chunk 3, A1). Three atomic commits, ~50-70 file ops,
    zero physics drift, zero Rust changes, no new dependencies.
    End state: mujoco/elrobot_follower/ becomes a fresh-checkout-runnable
    robot package; cp -r to /tmp + pytest tests/ passes 17/18; robot.yaml
    upstream.prerequisites moves from 1/5 done (Chunk 0) to 3/5 done (LICENSE
    + self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
2026-04-11 spec: MVP-3 Foundation roadmap — fix iteration 2 review issues
    Iteration 2 review verified all 10 iter-1 fixes are correct, but found
    2 new issues introduced by Appendix A and 1 nuance lost in Section 5
    prereq:
    1. Appendix A Post-Chunk-0 cp -r self-containment cell was factually
    wrong — claimed "4+1s" but reviewer empirically verified at HEAD
    6ef605b that cp -r /tmp produces "0 passed, 2 failed, 3 skipped"
    because meshdir="../../assets" doesn't resolve in /tmp. The package
    is NOT self-contained at HEAD — that's exactly what MVP-3 is here to
    fix. Updated the cell to "N/A — package not self-contained yet" with
    explicit note that this failing state is the motivation f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
2026-04-11 spec: MVP-3 Foundation roadmap → Engine Package Completion (codex iter-1 fixes)
    Codex iter-1 review (consult session 019d7726, gpt-5 xhigh) found 4
    critical structural defects in the iter-3 spec that internal
    spec-document-reviewer rounds couldn't catch (because they're
    spec-vs-code consistency issues, not internal-doc consistency):
    CRITICAL FIX 1 — Milestone framing
    ================================
    Codex correctly pointed out that A3 (scene.xml viewer wrapper) is
    upstream/visualization ergonomics, not foundation infrastructure. The
    "MVP-3 Foundation" name was misleading. Renamed to "MVP-3 Engine Package
    Completion" throughout. Section 1 now explicitly says "Chunks 1 and 3 are
    foundatio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
2026-04-11 spec: MVP-3 EPC roadmap — fix iter-4 leftovers (3 leaks + 1 cosmetic)
    spec-document-reviewer iteration 4 found 3 small mechanical inconsistencies
    that survived the substantial iter-4 codex-fix rewrite + 1 cosmetic
    holdover. All non-blocking but worth fixing for internal consistency:
    1. Section 1 success criterion #4 still embedded the absolute count "≥90
    passed". The whole point of the iter-4 rewrite was to eliminate
    absolute counts in favor of baseline-relative deltas. Replaced with
    "passed ≥ chunk_0_baseline_passed + 2" with explanation of where the
    +2 comes from.
    2. Section 2 inventory table Chunk 3 prereq cell still labeled Chunk 2
    as "soft + count-hard, see Sectio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
2026-04-12 spec: MVP-3 EPC roadmap — codex iter-2 fixes (sentinel + scope + 2 stale)
    Codex iter-2 verdict: Critical fixes 1+2 PASS, 3 PARTIAL, 4 FAIL, all
    8 hardening PASS. 4 specific changes required before green light. All
    applied:
    1. Sentinel test body strengthened (Section 5)
    Codex flagged that the original sentinel only asserted
    `world.actuator_id_for("act_motor_08") is not None`, which would still
    pass even if the gripper actuator_annotations were silently dropped
    (because load_manifest auto-synthesizes act_motor_08 as a plain
    REVOLUTE_POSITION at manifest.py:187). Strengthened the sentinel to
    verify:
    - world.manifest.world_name == "elrobot_follower"
    - world.actuato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
2026-04-12 spec: MVP-3 EPC roadmap — fix codex iter-3 advisory typo
    Codex iter-3 final verdict: GREEN LIGHT. Single non-blocking advisory:
    the package-local-counts example said "4 passed + 0 skipped OR 5 passed
    + 0 skipped" — the first half can't be right (4 passed means mjx is
    skipped, so it's "+1 skipped", not "+0"). Reworded the conditional
    clearly:
    "4 passed + 1 skipped (mjx absent) OR 5 passed + 0 skipped (mjx present)"
    Spec is now ready to hand off to writing-plans after user review.
2026-04-12 plan: MVP-3 Chunk 1 — assets+urdf move into elrobot_follower package
    1189-line single-task atomic plan for MVP-3 Engine Package Completion
    Chunk 1 (A2: Assets+URDF Move). Source spec is the roadmap spec
    Section 3 at commit aa65fd3.
    Scope:
    - 19 STL git mv operations (per-file enumerated, not bash loop —
    matching Chunk 0's verified pattern)
    - 1 URDF git mv
    - meshdir simplification in MJCF (../../assets → assets)
    - test_urdf_parity.py 4 in-file edits (path layer + skip→fail upgrade
    + unused param fix + docstring drift fix)
    - README.md Structure section + line 35 self-containment update
    - CHANGELOG.md new [0.2.0] entry + [0.1.0] line 82 status update +
    [0.1.0] TBD backfill (Chunk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
2026-04-12 plan: MVP-3 Chunk 1 — apply plan-document-reviewer minor fixes
    3 non-blocking nits + 1 advisory rec from plan-document-reviewer all
    1. Line 128 prose count typo: "covering 3 things ... [4 things listed]"
    and "covering 2 things ... [3 things listed]" → corrected to 4 and 3.
    2. Step B.3 title said "(and remove it)" but body explicitly leaves the
    empty dir (correct behavior — git doesn't track empty dirs). Title
    changed to "Verify the source assets/ directory is now empty".
    3. Added a "Note for Chunk 2 plan author" at end of Completion Criteria
    documenting the intentional <TBD-mvp3-chunk1> placeholder in
    README.md (Step C.3 Edit 3b). The placeholder is chicken-a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
2026-04-12 mvp3-c1: move assets+urdf into mujoco/elrobot_follower/ package
    Chunk 1 of MVP-3 Engine Package Completion: moves all 19 STL meshes
    under hardware/elrobot/simulation/assets/ and hardware/elrobot/simulation/
    elrobot_follower.urdf INTO the engine-tier robot package at
    hardware/elrobot/simulation/mujoco/elrobot_follower/. The package is now
    fully self-contained:
    cp -r mujoco/elrobot_follower /tmp/test && cd /tmp/test && pytest tests/
    passes for the first time (4 passed + 1 mjx skip). This is the only true
    hard prerequisite for Chunk 3 (test_elrobot_acceptance.py rewrite) per
    roadmap spec Section 6.
    What moved (20 git rename operations):
    hardware/elrobot/simulation/assets/*.stl
    -> har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
    [Gripper_Base_v1_1.stl, Gripper_Gear_v1_1.stl, Gripper_Jaw_01_v1_1.stl, Gripper_Jaw_02_v1_1.stl, Joint_01_1.stl, Joint_02_1.stl, Joint_03_v1_1.stl, Joint_04_v1_1.stl]
2026-04-12 mvp3-c1-polish: Chunk 1 code-review fixes + γ lessons doc
    Bundles 4 things into one small follow-up commit per Section 7 (γ)
    commitment + Chunk 1 code-quality reviewer's deferred items:
    1. (γ) New file: docs/superpowers/notes/lessons-from-mvp3-chunk0.md
    - ~150 lines lessons-learned doc capturing the "always grep first
    when writing path-migration plans" rule (Section 7 (α))
    - Enumerates the 4 Chunk 0 oversight cases as concrete examples
    (test_menagerie_walking_skeleton.py:34 silent skip, 3 sim-server
    README.md hits, measurements/menagerie_diff.md self-ref,
    station-sim-menagerie.yaml comment)
    - Covers (α') baseline-relative deltas as the companion rule
    - D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
2026-04-12 plan: MVP-3 Chunk 2 — scene.xml Menagerie-style wrapper
    Per-chunk plan for Chunk 2 of MVP-3 Engine Package Completion. Source
    spec is roadmap Section 4 at commit aa65fd3+ (current spec HEAD includes
    codex iter-3 hardening). Smaller plan than Chunk 1 (~700 lines vs 1191)
    because Chunk 2 is the smallest chunk in the milestone — pure additive
    content + 2 polish backfills.
    Plan structure (6 phases, ~22 bite-sized steps):
    - Phase A: pre-flight (verify HEAD + Chunk 1 end-state, capture
    BASELINE_PASSED/SKIPPED, re-run 2 placeholder backfill greps)
    - Phase B: Create new files (scene.xml + test_scene_loadable.py),
    manual smoke compile of scene.xml in Step B.2 before writing the
    test
    - Phas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
2026-04-12 mvp3-c2: add scene.xml Menagerie-style wrapper + smoke test
    Chunk 2 of MVP-3 Engine Package Completion: adds a Menagerie-style scene
    wrapper to the engine-tier robot package and a 3-test smoke gate. After
    this chunk, running `python3 -m mujoco.viewer hardware/elrobot/simulation/
    mujoco/elrobot_follower/scene.xml` opens an ElRobot visualization with
    floor and lights — the upstream/visualization ergonomics half of MVP-3
    EPC is done. The other half (test decoupling) waits for Chunk 3.
    What was added:
    - mujoco/elrobot_follower/scene.xml — ~30-line Menagerie-style wrapper
    containing <include file="elrobot_follower.xml"/>, <statistic>,
    <visual> (headlight + haze + camera angle), <asset>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
    [elrobot_follower.scene.yaml, robot.yaml, scene.xml]
2026-04-12 mvp3-c3-del: delete old acceptance test + bump metadata to 0.2.2
    Delete software/sim-server/tests/integration/test_elrobot_acceptance.py
    (13 physics tests now live in engine package at
    mujoco/elrobot_follower/tests/test_elrobot_acceptance.py).
    Manifest-layer coverage preserved by sentinel.
    Clean up dead elrobot_mjcf_path fixture from sim-server conftest
    (elrobot_scene_yaml kept — used by sentinel and 5+ other tests).
    Fix stale test path reference in software/sim-server/README.md.
    Annotate CHANGELOG [0.1.0] historical reference.
    Bump VERSION 0.2.1 -> 0.2.2. Update CHANGELOG, robot.yaml (mark
    'tests in isolation' upstream prereq done), README.
    make sim-test: 94 passed, 1 skipped (baseline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
    [robot.yaml]
2026-04-12 plan: MVP-3 Chunk 3 — test decoupling implementation plan
2026-04-12 spec: MVP-4 A4 — upstream prep (Menagerie-match) design
2026-04-12 mvp4-a4: upstream prep — CITATION.cff + thumbnail + contribution guide
    Add CITATION.cff (CFF 1.2.0, repository-only citation).
    Add elrobot_follower.png render thumbnail (640x480, Menagerie convention).
    Add tools/render_thumbnail.py for deterministic headless regeneration.
    Add docs/upstream-to-menagerie.md contribution guide with prerequisite
    checklist, file mapping, and submission steps.
    Bump VERSION 0.2.2 -> 0.2.3. Update CHANGELOG, robot.yaml (mark
    CITATION.cff prereq done -> 4/5 upstream prerequisites met),
    README (file tree).
    make sim-test: 94 passed, 1 skipped (unchanged).
    Only sysid_complete remains before upstream submission.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
    [robot.yaml]
2026-04-12 vendor: import TheRobotStudio SO-ARM100 SO101 simulation files
    Vendor SO101 MuJoCo/URDF files from TheRobotStudio/SO-ARM100 at commit
    fda892c (2026-02-26). Contains real STS3215 servo parameters (kp=17.8,
    armature=0.028, damping=0.60) adapted from Open Duck Mini — significantly
    more accurate than Menagerie's experience-based values (kp=50, armature=0.1).
    Includes backlash class definition (0.5 deg), dual calibration variants,
    and 26 mesh files. Gripper has same known limitation as Menagerie (single
    revolute joint, cannot physically close).
    Menagerie vendor preserved as walking-skeleton regression baseline.
    TheRobotStudio vendor serves as parameter reference for future SO-100
    first-class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
2026-04-12 config: add TheRobotStudio SO101 station integration
    Add Norma manifest, bridge preset, and station config for the
    TheRobotStudio SO101 vendor model. Same pipeline as Menagerie
    walking skeleton but with real STS3215 servo parameters.
    Launch: station -c station-sim-therobotstudio.yaml --web
    [station-sim-therobotstudio.yaml, therobotstudio-so101.yaml, therobotstudio_so101.scene.yaml]
2026-04-12 make: add mjviser web viewer targets for WSL2 debug
    make viewer-elrobot → ElRobot scene.xml on :8012
    make viewer-so100 → Menagerie SO-100 on :8012
    make viewer-so101 → TheRobotStudio SO-101 on :8012
    Browser-based MuJoCo viewer (mjviser) solves WSL2 OpenGL issue.
    Shows collision mesh groups, contact forces, joint sliders.
    Use alongside station web (:8889) for control + debug.
2026-04-12 fix(bridge): set range_freezed=true for simulation motors
    Simulation motors have known ranges from the MJCF model and don't
    need calibration. Setting range_freezed=false caused the station
    web UI to show a "Calibrate" button and potentially restrict control.
    [state_task.rs]
2026-04-12 fix(bridge): auto-compute actuator step range from MJCF ctrlrange
    Add ctrl_range_min/max fields to ActuatorDescriptor proto. norma_sim
    fills them from MjModel.actuator_ctrlrange at startup. The bridge
    reads the descriptor and computes per-actuator step ranges via
    rad_to_steps(), replacing the preset's fixed 0/4095 values.
    This fixes the web UI slider mapping for actuators with asymmetric
    ranges (e.g. gripper ctrlrange [-0.175, 1.745] -> steps 1934-3186
    instead of 0-4095). The slider now maps 0-100% to the actual usable
    joint range, matching mjviser's behavior.
    No web UI changes needed — it already uses rangeMin/rangeMax correctly.
    Falls back to preset values when ctrlrange is not reporte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
    [state_task.rs]
2026-04-12 experiments: bootstrap Robot Control Stack (RCS) study
    RCS is the textbook sim-to-real architecture: Gymnasium wrapper with
    physical units (radians) throughout, zero hardware protocol in the
    control path. Already supports SO101 — directly comparable to
    NormaCore's SO-100/ElRobot pipeline.
    Key study focus: wrapper composition pattern (SimEnv → RobotWrapper →
    GripperWrapper), GripperConfig with ctrlrange in radians, and
    extension-per-robot model.
    rcs-ref/ cloned at 66d4988, gitignored.
2026-04-12 feat(sim): add Gymnasium env, stepping scheduler, mjviser viz, and episode recording
    NormaSimEnv — a Gymnasium-compatible env that talks directly to
    norma_sim over Unix socket in step-on-demand mode, bypassing Station
    for deterministic training. Includes mjviser web 3D visualization
    (--render-port) and an EpisodeRecorder wrapper for imitation learning
    data collection.
    Protocol: add StepRequest/StepResponse/ResetRequest to the Envelope
    oneof in world.proto. Stepping mode advances physics on demand with
    causal action→observation guarantees.
    Bug fixes from Codex review: correct action_hz timing (round instead
    of floor division), wire seed through reset chain, read real velocity
    from MuJo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
2026-04-12 feat(sim): add LeRobot Robot adapter for NormaSimEnv
    NormaSimRobot implements LeRobot's Robot protocol (connect, get_observation,
    send_action, disconnect) wrapping NormaSimEnv. Feature names match LeRobot's
    SO-Follower convention (shoulder_pan.pos, gripper.pos, etc.) so policies
    trained on SO-101 hardware data work directly with our sim.
    Architecture: LeRobot handles training (ACT/Diffusion/pi0), NormaCore
    provides sim with precise TheRobotStudio physics model for eval and
    sim-real comparison.
    7 new tests, 93 total passing.
2026-04-12 feat(sim): add camera rendering to stepping mode
    MuJoCo offscreen renderer produces RGB camera frames in the stepping
    subprocess, transmitted via CameraFrame/SensorSample in WorldSnapshot.
    Two default camera presets (top, wrist.top) match common LeRobot SO-101
    setups.
    Pipeline verified end-to-end: HuggingFace ACT checkpoint → real MuJoCo-
    rendered camera images → policy inference → sim physics → mjviser 3D
    visualization.
    CLI: --cameras top wrist.top
    Python: NormaSimEnv(cameras=["top", "wrist.top"])
    93 tests pass (no regression).
2026-04-12 feat: ACT policy execution through Station (Path B)
    Add test_policy_station.py that runs a HuggingFace ACT checkpoint
    through the full Station pipeline: station_py → commands queue →
    st3215-compat-bridge → norma_sim realtime. Same control path as
    real hardware deployment.
    Enable NormFS TCP port (--tcp 0.0.0.0:8888) in sim-debug-so101
    Makefile target so station_py can connect.
    Verified: policy actions flow through 7-layer Station stack, motor
    state reads back through st3215/inference queue, rad↔steps conversion
    correct (2048 offset = 0 rad).
    [test_policy_station.py]
2026-04-12 feat: add local MuJoCo camera rendering to Station policy eval
    Policy execution through Station (Path B) now renders camera images
    locally using a MuJoCo model copy synced from Station's motor state.
    Eliminates dummy black images that caused the policy to output only
    conservative small actions.
    Verified: first-step action magnitude increased 5x (-0.764 rad vs
    +0.158 rad with dummy images), confirming visual input drives
    meaningful policy behavior.
2026-04-12 feat: tabletop scene with cube target, MJCF cameras, and unified mjviser
    Add scene_tabletop.xml: table surface + red graspable cube + two fixed
    cameras (top, wrist.top) matching LeRobot SO-101 conventions. Camera
    rendering now prefers MJCF-defined cameras over free camera presets.
    Unify mjviser across both modes: realtime mode now renders mjviser from
    norma_sim's own model/data (same as stepping mode), replacing the
    disconnected standalone mjviser process. Station Web UI (:8889) and
    mjviser (:8012) now show the SAME simulation state.
    [station-sim-therobotstudio.yaml, therobotstudio_so101_tabletop.scene.yaml]
2026-04-12 fix(sim): defer mjviser init in realtime mode to avoid blocking IPC handshake
    ViserMujocoScene initialization (3-5s) was blocking the asyncio event
    loop, preventing Station's IPC handshake from completing. Move mjviser
    init to a background thread so the IPC server can accept connections
    immediately.
    Also fix UnboundLocalError caused by shadowed `import threading` inside
    the mjviser try block.
2026-04-12 feat(sim): add camera position markers + use tabletop scene in Station
    Visual camera markers (dark box + blue lens) show camera positions in
    the 3D scene. Collision-free (contype=0). Helps debug camera placement
    in mjviser before mounting real cameras.
    Switch Station YAML to tabletop scene (table + red cube + cameras).
    [station-sim-therobotstudio.yaml]
2026-04-12 feat(sim): live camera feed panels in mjviser GUI sidebar
    Render camera views (MuJoCo offscreen) and display as JPEG images in
    mjviser's GUI sidebar via viser.gui.add_image(). Works in both stepping
    and realtime modes. Camera feeds update in sync with physics.
    Open http://localhost:8012 → 3D viewport shows the scene, sidebar shows
    what each camera sees in real-time.
    [station-sim-therobotstudio.yaml]
2026-04-12 fix(sim): lazy-init camera renderers in physics thread to avoid race
    Camera renderers were being created in the mjviser background thread
    while the physics thread's publish_cb tried to access them — race
    condition causing crash under Station. Move renderer creation to
    first publish_cb call (physics thread owns them, no race).
2026-04-12 perf(sim): throttle realtime camera feed to ~10Hz (was 100Hz)
    Rendering 2 cameras at 100Hz publish rate caused severe physics
    overruns on CPU. Reduce to every 10th tick (~10Hz) — still smooth
    enough for monitoring, 10x less render load.
2026-04-12 wip: scripted pick-and-place demo recording script
    Records reach→approach→grasp→lift trajectory to LeRobotDataset format
    using NormaSimRobot. Camera rendering on CPU is slow — needs perf
    optimization before recording full datasets.
2026-04-12 feat(sim): FastSim in-process MuJoCo + single-process batch generator
    Add norma_sim/fast_sim.py: direct MuJoCo without subprocess/IPC/protobuf.
    Rewrite batch_generate.py: single process, configurable camera resolution,
    direct LeRobot dataset write (no .npz intermediate).
    Add build_dataset_from_npz.py for legacy npz→dataset conversion.
    Key finding: WSL2 EGL uses CPU software rendering (llvmpipe, 175ms/frame).
    GLX with d3d12 driver routes through GPU (36.9ms/frame, 4.7x faster).
    Resolution has minimal impact on GPU (37 vs 41ms); camera count is linear.
2026-04-12 feat(sim): dual-backend sim factory (CPU + MJX stub)
    Add sim_factory.py with create_sim() that auto-selects CPU (FastSim)
    or GPU (FastSimMJX) backend based on JAX availability and env count.
    Add fast_sim_mjx.py as interface contract for future MJX implementation.
    CPU and GPU backends serve different stages:
    - CPU: debugging, eval visualization, small data gen, while GPU trains NN
    - GPU/MJX: massive parallel data gen (10K+ envs), RL training loops
    Both share world/manifest.py and world/capabilities.py.
2026-04-12 feat(sim): implement FastSimMJX with batched step/reset
    Full MJX implementation: manifest-driven actuator mapping, pre-computed
    ctrl scales/offsets as JAX arrays, jax.lax.scan for substeps.
    Known constraint: SO-101 tabletop scene has complex mesh colliders
    that cause 12+ minute JIT compilation and high GPU memory usage.
    CPU FastSim (37ms/frame with d3d12 GPU rendering) remains the
    recommended backend until meshes are simplified for MJX.
2026-04-12 refactor(sim): centralize camera presets, LeRobot helpers, add contract tests
    Per Codex review:
    - Extract cameras.py: single source for camera poses (was duplicated
    in stepping.py and fast_sim.py)
    - Extract lerobot_helpers.py: gripper 0-1↔0-100 conversion, obs key
    remapping, state/action vector builders (was duplicated in 3 places)
    - Add test_fast_sim.py: 9 contract tests for FastSim obs format,
    physics advancement, reset behavior, and LeRobot helper roundtrip
    - Fix stale comments: gym_env.py "no camera" → documents camera support,
    test_policy_eval.py dummy images → documents real camera fallback
    - Quarantine sim_factory.py: mark experimental, document backend
    disparity (MJX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
2026-04-12 refactor(sim): Phase 0+1+2 — gripper fix, classification uplift, RobotEnv Protocol
    Phase 0: Fix gripper semantic mismatch between FastSim and gym_env.
    FastSim now maps gripper [0,1] through MuJoCo ctrlrange (matching
    gym_env behavior). Previously used capabilities.py identity which
    produced different ctrl values for REVOLUTE_POSITION grippers.
    Phase 1: Extract joint/gripper classification to MuJoCoWorld.
    Add joint_actuators/gripper_actuators cached properties with
    _is_gripper() as single source of truth. Remove duplicated
    heuristic from fast_sim.py, fast_sim_mjx.py (was in 3 places).
    Phase 2: Define RobotEnv Protocol (robot_env.py).
    Runtime-checkable Protocol for reset/step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
2026-04-12 feat(sim): Phase 3+4+5 — RobotSpec, Task abstraction, experiment config
    Phase 3: Dynamic joint names via RobotSpec.
    RobotSpec.from_world(world) derives joint/gripper names from manifest.
    RobotSpec.so101() provides backward-compatible defaults.
    Eliminates need to hardcode JOINT_NAMES per robot.
    Phase 4: Task abstraction (norma_sim/tasks/).
    Task Protocol with generate_trajectory(), check_success().
    PickAndPlace as first implementation with domain randomization.
    Task registry for lookup by name.
    Phase 5: ExperimentConfig (norma_sim/experiment.py).
    Single YAML drives robot, sim backend, cameras, task, dataset,
    and training config. experiments/pick_v1.yaml as first instance.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
2026-04-12 feat(sim): run_experiment.py — one command drives full pipeline
    Single YAML config → data generation → training → evaluation.
    Consumes all new abstractions: ExperimentConfig, Task, RobotSpec,
    FastSim. Validates the full architecture chain end-to-end.
    Usage:
    PYTHONPATH=. python3 scripts/run_experiment.py experiments/pick_v1.yaml
    PYTHONPATH=. python3 scripts/run_experiment.py experiments/pick_v1.yaml --phase data
    Tested: 5 episodes → 500-step ACT training → 5-episode eval, all passing.
2026-04-13 feat(sim): data quality validation — 3-layer checks + pipeline integration
    Add norma_sim/data_quality.py with validate_dataset():
    Layer 1 (per-frame): NaN/Inf detection, joint limit checks, image sanity
    Layer 2 (per-episode): gripper activity, state variance, trajectory structure
    Layer 3 (cross-dataset): diversity, DR coverage, duplicate detection
    Add scripts/validate_dataset.py CLI wrapper.
    Integrate as Phase 1.5 in run_experiment.py (between data gen and training).
    Critical failures (>20% episodes bad) abort the pipeline.
    First run caught real issue: frozen camera images across 99% of frames
    in the quick dataset — needs investigation (possible video codec artifact).
    Co-Authore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
2026-04-13 fix(sim): frozen camera false positive — use image mean diff not byte hash
    The previous hash-based check only compared the first 1KB of image
    bytes (~10 rows of pixels). Background-dominated images (sky/table)
    had identical top rows even when the robot moved, causing 99% of
    frames to be flagged as "frozen".
    Fix: compare full-image mean values with 1e-5 tolerance. Verified:
    consecutive frames have mean diffs of 2000-4000 (clearly different).
    Now correctly reports 5/5 passed, 0 warnings.
2026-04-13 feat(sim): SimToRealAdapter — bridge the sim-to-real gap
    Add norma_sim/sim_to_real.py: transparent degradation layer that
    injects sensor noise, action delay, calibration offset, camera
    latency, brightness jitter, and observation dropout into sim data.
    Three presets: off() / mild() / aggressive() — start conservative,
    increase based on real-robot eval results.
    Integration:
    - NormaSimRobotConfig.sim_to_real wraps FastSim with adapter
    - ExperimentConfig.sim.sim_to_real section in YAML
    - experiments/pick_v1_robust.yaml as example
    Architecture:
    adapter OFF → validate pipeline, measure sim performance
    adapter ON → train robust policy for real deployment
    real hardware →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
2026-04-13 refactor(sim): gripper normalization via capabilities.py (single authority)
    Add gripper_command_to_ctrl() and gripper_qpos_to_normalized() to
    capabilities.py. These handle BOTH GRIPPER_PARALLEL (via manifest
    metadata) and REVOLUTE_POSITION grippers (via ctrlrange interpolation).
    FastSim now delegates all gripper conversion to capabilities.py
    instead of inline ctrlrange math. This prevents the double-
    normalization bug that would occur with GRIPPER_PARALLEL actuators
    where gym_env's snapshot.py already normalizes via capabilities,
    then gym_env re-normalizes via ctrlrange.
    capabilities.py is now the SINGLE source of truth for:
    - Joint control: command_value_to_ctrl()
    - Joint observation: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
2026-04-13 perf(sim): validation sampling — 20 episodes × 30 frames, not full scan
    Previous: scanned all 52K frames (200 × 260), took 30+ minutes due
    to LeRobot parquet image decoding. Now samples 20 episodes with 30
    evenly-spaced frames each (600 total loads). Sufficient to detect
    quality issues without blocking the training pipeline.
2026-04-13 fix(sim): optimize camera placement — wider top + true front view
    top: elevation -60°→-75° (more bird's eye), distance 0.6→0.75 (wider)
    front: new camera replacing "wrist.top" — elevation -20° (near eye-level),
    distance 0.7, azimuth 180°. Shows cube depth clearly.
2026-04-15 docs(experiments): bimo incubation Phase 1 — Codex-validated sim2real insights
    Phase 1 source study of the-bimo-project (bipedal RL with Isaac Lab +
    RSL-RL PPO) to extract transferable sim-to-real methodology for
    NormaCore's MuJoCo + pi0 imitation stack.
    All findings went through an independent Codex verification pass —
    every claim is annotated "partially correct" and includes counter-
    evidence with file:line citations. Key corrections (see insights.md §七):
    - pi0 ↔ Station deployment gap is worse than initially described:
    train_pi0_openpi.py repacks images as images.cam_high but openpi
    expects image.* + image_mask structure — data contract is broken
    before deployment, not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
2026-04-15 feat(sim): task success metric — check_success + eval_policy success rate
    Replace the check_success stub in PickAndPlace with a real bool return
    based on cube horizontal displacement, and plumb object pose through
    the obs path so eval_policy can score episodes.
    Changes:
    - FastSim: new tracked_objects ctor arg, resolves body names via
    mj_name2id and exports obs["object.<name>.pos"] + ".quat" in
    _build_obs. Missing bodies are silently skipped so scenes without
    the tracked object still work.
    - sim_obs_to_lerobot: pass object.* keys through to the flat LeRobot
    dict alongside camera.* (no new policy-input pollution — pi0/ACT
    only read observation.state + observation.images.*).
    - No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
